kevin-horrigan/tcd-phantom/refs/REFERENCES.md

# References

PDFs are **not** committed to this repository. Most of these are under publisher copyright and
redistributing them, even for coursework, is not something a public repo should do.

**Project members:** the PDFs are in a shared Drive folder, access restricted to GWU accounts.

> https://drive.google.com/drive/folders/1BS4GFaekAu13mgtEKKH5-q6HEAU1PLzF

If that link does not open for you, ask the advisor for access rather than assuming the file is
missing. Everyone else: obtain each item through your own institutional library. Items marked **OA**
are open access and free to download from the publisher.

Annotations for each item, including what it is actually useful for, are in `../INDEX.md`.

Licence column reflects a check of the article's own front matter on 2026-09-11. Where it says
*verify*, the front page carried no clear statement and you should check the publisher page before
assuming anything.

## Phantom construction and flow loops

| # | Citation | DOI / locator | Licence |
|---|---|---|---|
| 1 | Greaby R, Zderic V, Vaezy S. Pulsatile flow phantom for ultrasound image-guided HIFU treatment of vascular injuries. *Ultrasound Med Biol* 2007;33(8):1269-1276. | 10.1016/j.ultrasmedbio.2007.02.011 | © Elsevier, all rights reserved |
| 2 | Soloukey S, Generowicz B, Warnert E, et al. Patient-specific vascular flow phantom for MRI- and Doppler ultrasound imaging. *Ultrasound Med Biol* 2024;50:860-868. | 10.1016/j.ultrasmedbio.2024.02.010 | **OA**, CC BY |
| 3 | Roldan M, Kyriacou PA. Head phantom for the acquisition of pulsatile optical signals for traumatic brain injury monitoring. *Photonics* 2023;10:504. | 10.3390/photonics10050504 *(verify)* | **OA**, CC BY |
| 4 | Qian M, Niu L, Wong KKL, Abbott D, Zhou Q, Zheng H. Pulsatile flow characterization in a vessel phantom with elastic wall using ultrasonic particle image velocimetry technique: the impact of vessel stiffness on flow dynamics. *IEEE Trans Biomed Eng* 2014;61(9):2444-2452. | IEEE TBME 61(9) | © IEEE |
| 5 | Rominger MB, Müller-Stuler E-M, Pinto M, et al. Easy pulsatile phantom for teaching and validation of flow measurements in ultrasound. Thieme, Technical Development E93. | 10.1055/s-0042-106396 | © Thieme, redistribution prohibited |
| 6 | Vanrossomme AE, Chodzyński KJ, Eker OF, Zouaoui Boudjeltia K. Development of experimental ground truth and quantification of intracranial aneurysm pulsation in a patient. *Sci Rep* 2021. | 10.1038/s41598-021-88420-3 | **OA**, CC BY *(verify)* |
| 7 | Boonya-ananta T, Rodriguez AJ, Ajmal A, et al. Development of a dynamic pulsatile phantom for the photoplethysmographic waveform at the radial artery. *J Biomed Opt*. | JBO 030-117001 | **OA**, Creative Commons |
| 8 | Gorina AV, Galiastov AA, Stavtsev DD, et al. Design of brain vessel phantom model with aneurysm for bench tests using optical flow visualization methods. *2025 STDH*, IEEE. | 10.1109/STDH66836.2025.11227509 | © IEEE |
| 9 | Brumfiel TA, Konda R, Elliott D, Desai JP. Evaluating the navigation capabilities of a modified COAST guidewire robot in an anatomical phantom model. | arXiv:2512.13477v1 | arXiv, *verify* |

## What waveform to aim at

| # | Citation | DOI / locator | Licence |
|---|---|---|---|
| 10 | Robba C, Citerio G (eds). *Echography and Doppler of the Brain.* Cham: Springer; 2021. **Ch 7, Fedriga & Czosnyka**, flow velocity, PI, autoregulation and critical closing pressure. | ISBN 978-3-030-48202-2 | © Springer. Book, not redistributable |
| 11 | Tegeler CH, Crutchfield K, Katsnelson M, et al. Transcranial Doppler velocities in a large, healthy population. *J Neuroimaging* 2013;23(3):466-472. | 10.1111/j.1552-6569.2012.00711.x *(verify)* | *verify* |
| 12 | Aaslid R, Markwalder TM, Nornes H. Noninvasive transcranial Doppler ultrasound recording of flow velocity in basal cerebral arteries. *J Neurosurg* 1982;57:769-774. | J Neurosurg 57:769 | © JNS |

## Why the waveform has that shape

| # | Citation | DOI / locator | Licence |
|---|---|---|---|
| 13 | Westerhof N, Lankhaar JW, Westerhof BE. The arterial Windkessel. *Med Biol Eng Comput* 2009;47:131-141. **Read this one first**: the accessible review of why compliance shapes an arterial waveform. | 10.1007/s11517-008-0359-2 *(verify)* | *verify* |
| 13b | Stergiopulos N, Westerhof BE, Westerhof N. Total arterial inertance as the fourth element of the windkessel model. *Am J Physiol Heart Circ Physiol* 1999;276(1):H81-H88. Earlier, shares two authors with 13, and is the copy in the Drive folder. Adds inertance as a fourth element and gives healthy human values in Table 2. Read after 13, when you need numbers. | 10.1152/ajpheart.1999.276.1.H81 | © APS |
| 14 | Shoemaker LN, Matern T, Kamar F, et al. Blood pressure in human large cerebral arteries: a feasibility study. *Am J Physiol Heart Circ Physiol* 2025. | *(verify)* | Creative Commons |
| 15 | Permutt S, Riley RL. Hemodynamics of collapsible vessels with tone: the vascular waterfall. *J Appl Physiol* 1963;18:924-932. | 10.1152/jappl.1963.18.5.924 | © APS |

## Measurement caveats that govern every velocity comparison

| # | Citation | DOI / locator | Licence |
|---|---|---|---|
| 16 | Ambrogio S, Ansell J, Gabriel E, et al. (incl. Ramnarine KV). Pulsed wave Doppler measurements of maximum velocity: dependence on sample volume size. *Ultrasound Med Biol* 2022. | Elsevier | © Elsevier, all rights reserved |
| 17 | Vilkomerson D, Ricci S, Tortoli P. Finding the peak velocity in a flow from its Doppler spectrum. *IEEE Trans Ultrason Ferroelectr Freq Control* 2013. | IEEE TUFFC | © IEEE |
| 18 | Leotta DF, Anderson M, Straccia A, et al. Measurement of transcranial Doppler insonation angles from three-dimensional reconstructions of CT angiography scans. *J Clin Monit Comput* 2024. | Springer | © Springer |

## Named in the literature but not yet obtained

These are worth chasing. The first two are the fullest build documentation that exists for the two
architectures this project is combining.

- **Greaby R (2005).** A pulsatile flow phantom for image-guided HIFU treatment of vascular injury.
  MS thesis, Bioengineering, University of Washington. Interlibrary loan.
- **Bottan S.** *In-Vitro Model of Intracranial Pressure and Cerebrospinal Fluid Dynamics.* PhD
  thesis, ETH Zurich. The ICP-pulsation reference Roldan validates against. ETH theses are usually
  openly available.
- **IEC 61685.** Ultrasonics, flow measurement systems, flow test object. The standard. Check
  institutional access before assuming you can read it.
- **Ramnarine KV, Nassiri DK, Hoskins PR, Lubbers J (1998).** Validation of a new blood-mimicking
  fluid for use in Doppler flow test objects. *Ultrasound Med Biol* 24:451-459.
- A current TCD normal-values reference for MCA velocity and PI by age. Deliberately left open:
  choosing one and justifying the choice is part of the literature review.

## Citation discipline

Verify every citation against the actual article before it goes into written work, and never cite a
paper you have not opened. Several entries above were transcribed from other papers' reference lists
rather than from the articles themselves, and the *(verify)* marks are there for a reason.
