kevin-horrigan/tcd-phantom/cad/phantom-block-drawing.png

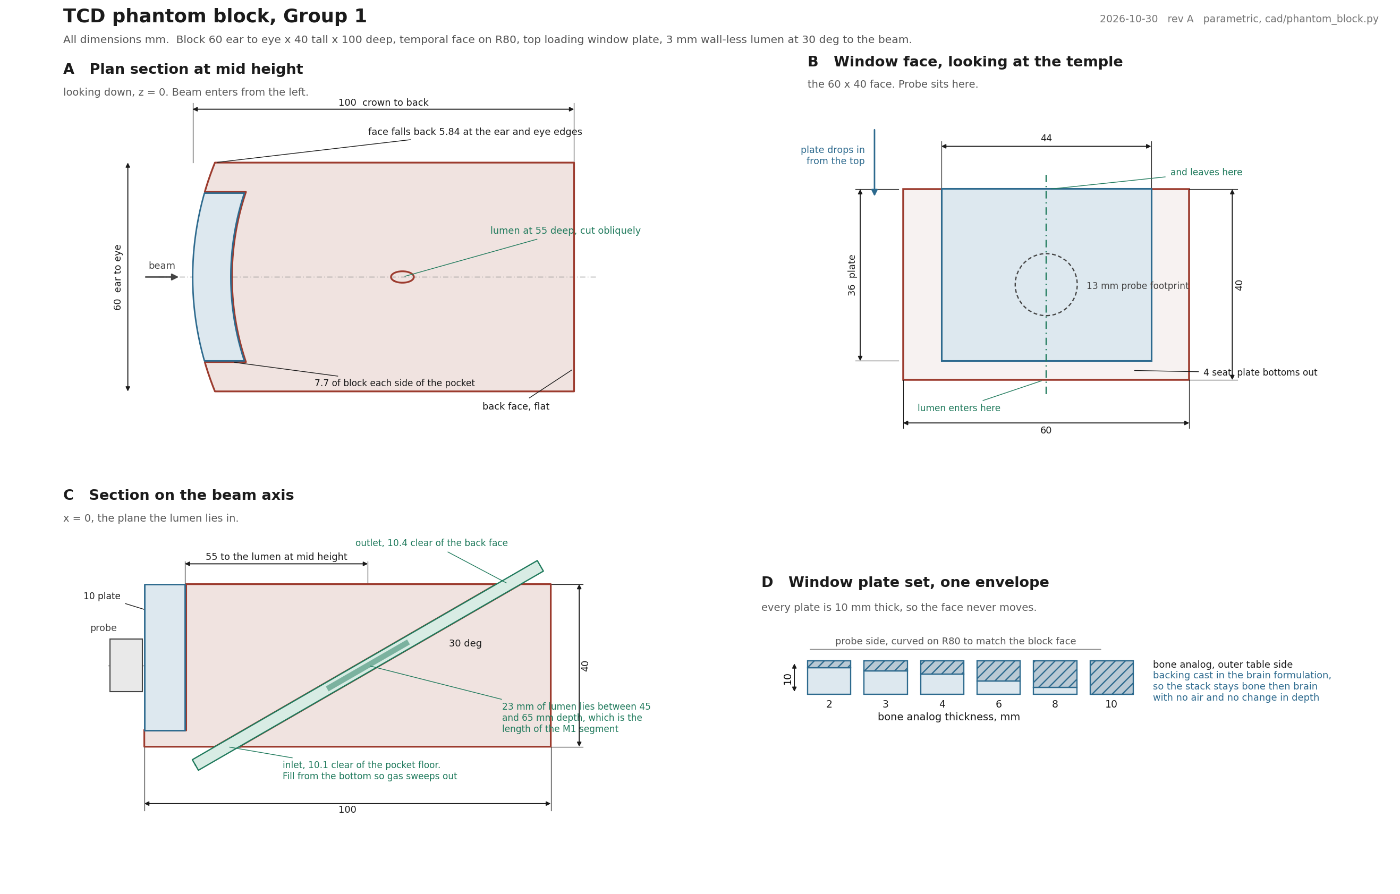
cad/phantom-block-drawing.png
