kevin-horrigan/tcd-phantom/cad/phantom-block-iso.png

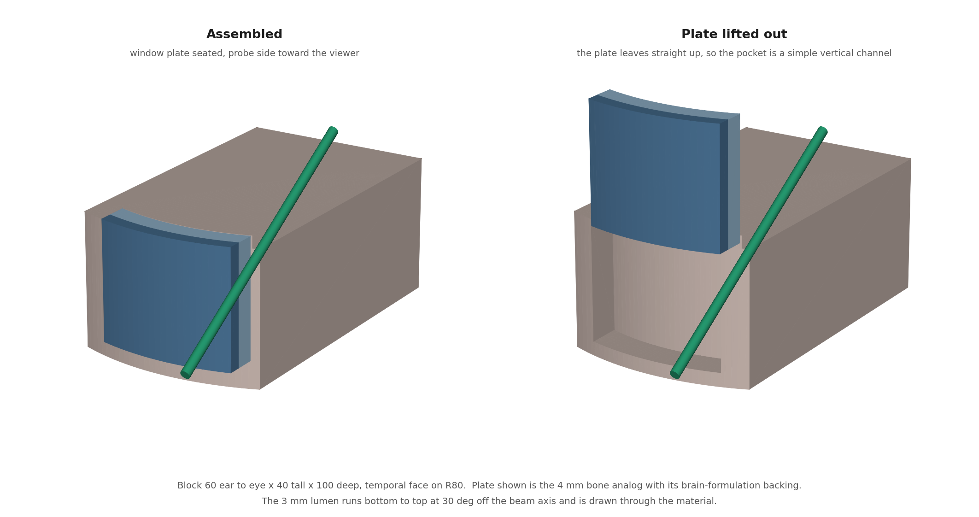
cad/phantom-block-iso.png
