kevin-horrigan/tcd-phantom/flow/architecture-fork.png

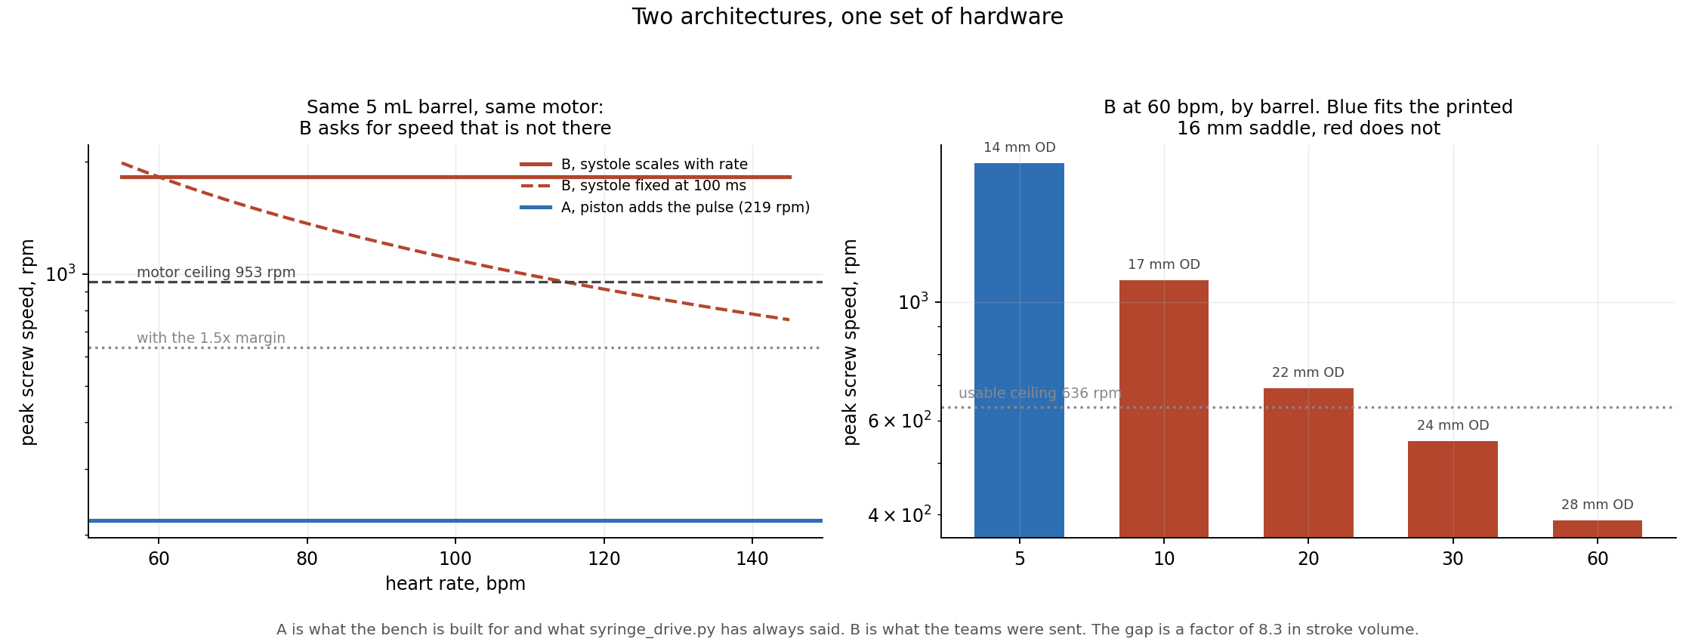
flow/architecture-fork.png
