kevin-horrigan/tcd-phantom/flow/ball-check.png

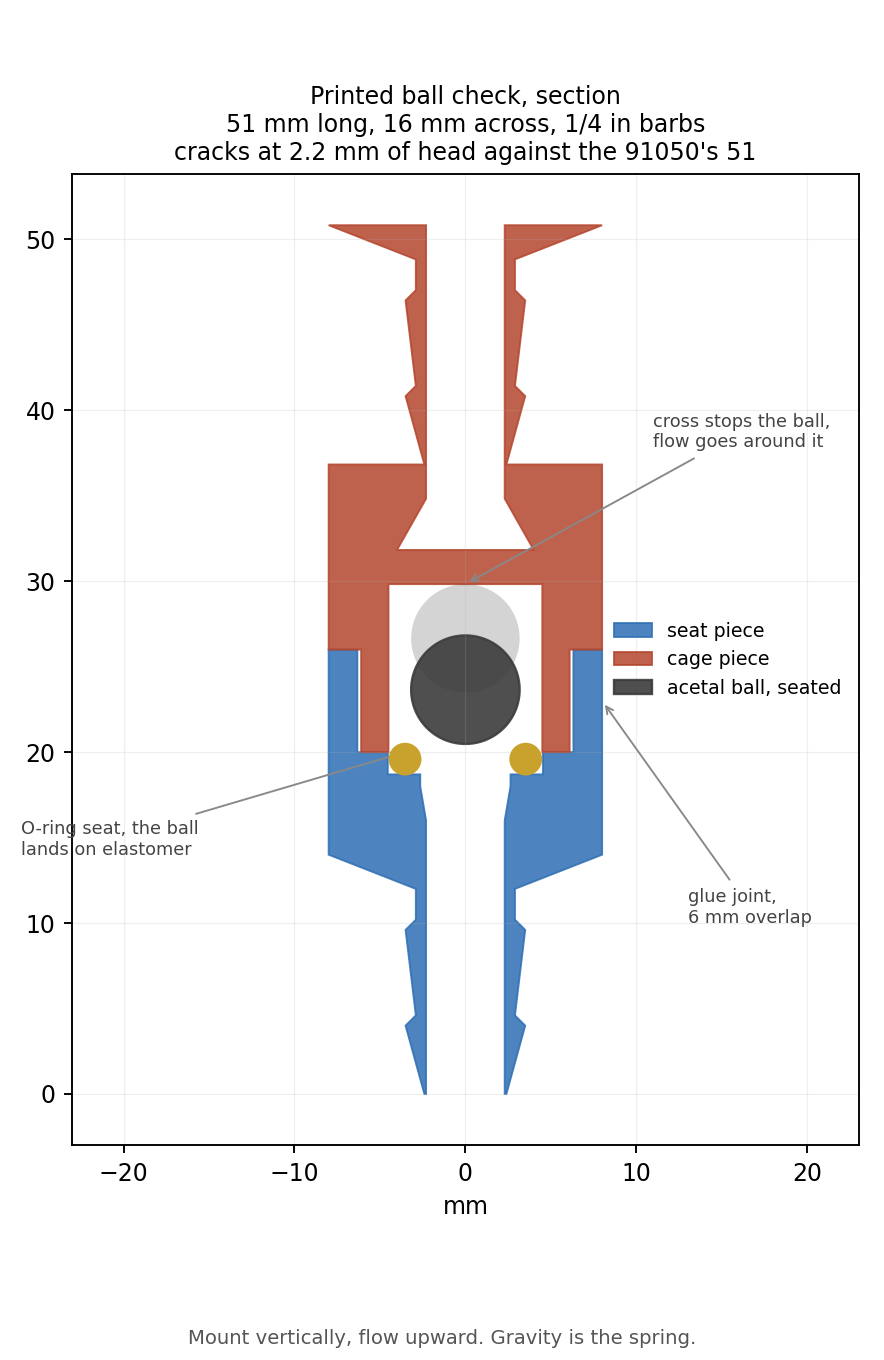
flow/ball-check.png
