kevin-horrigan/tcd-phantom/flow/bench-layout.png

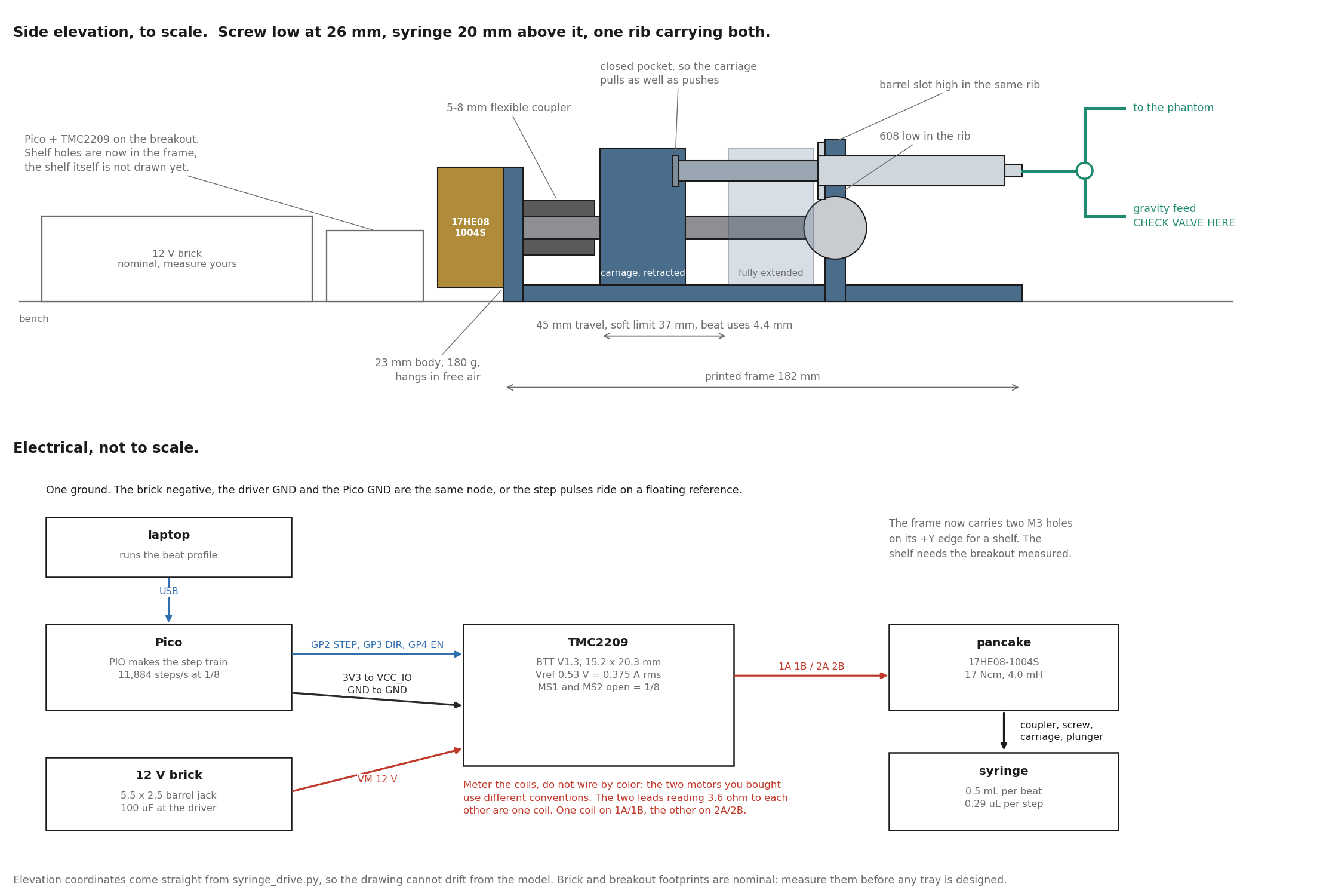
flow/bench-layout.png
