kevin-horrigan/tcd-phantom/flow/feed-tubing.png

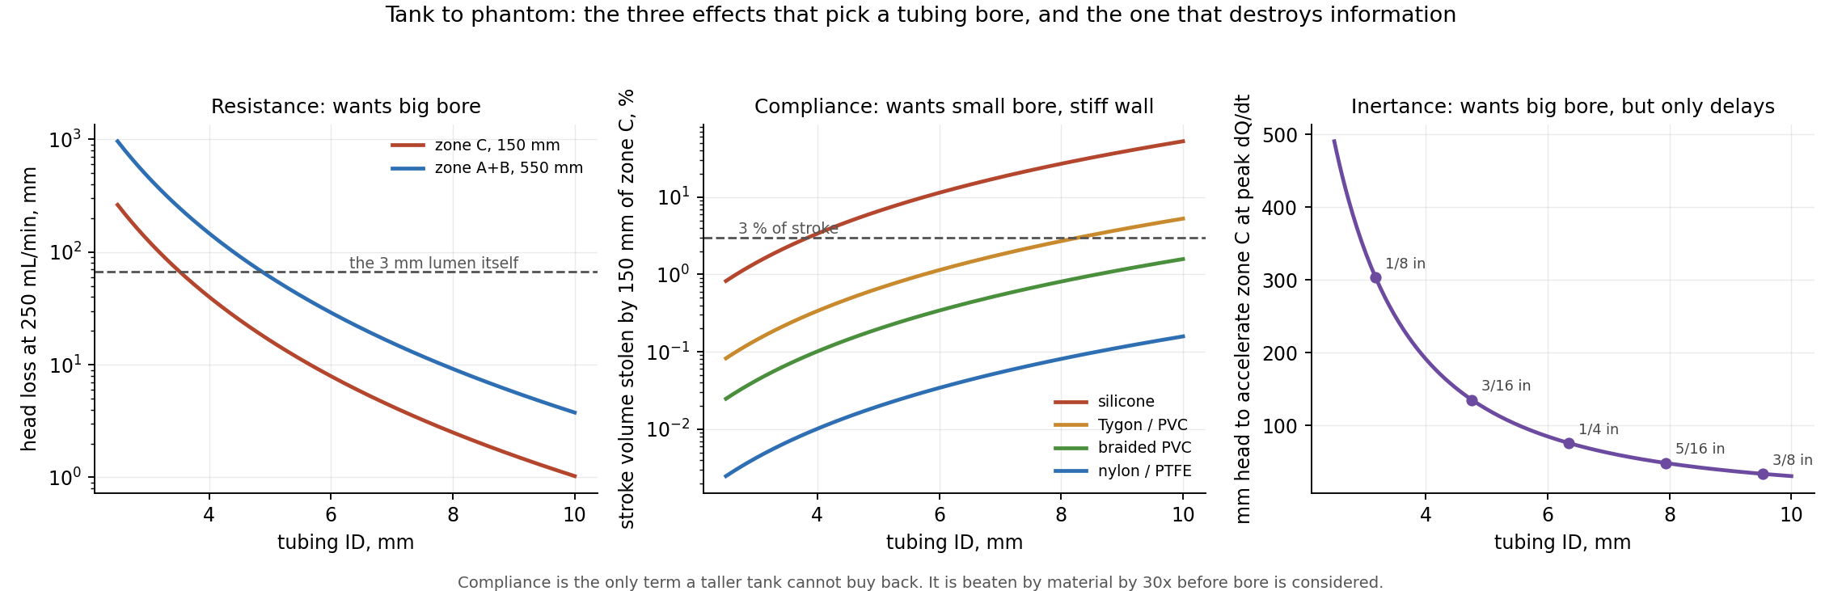
flow/feed-tubing.png
