kevin-horrigan/tcd-phantom/flow/frame-shape.png

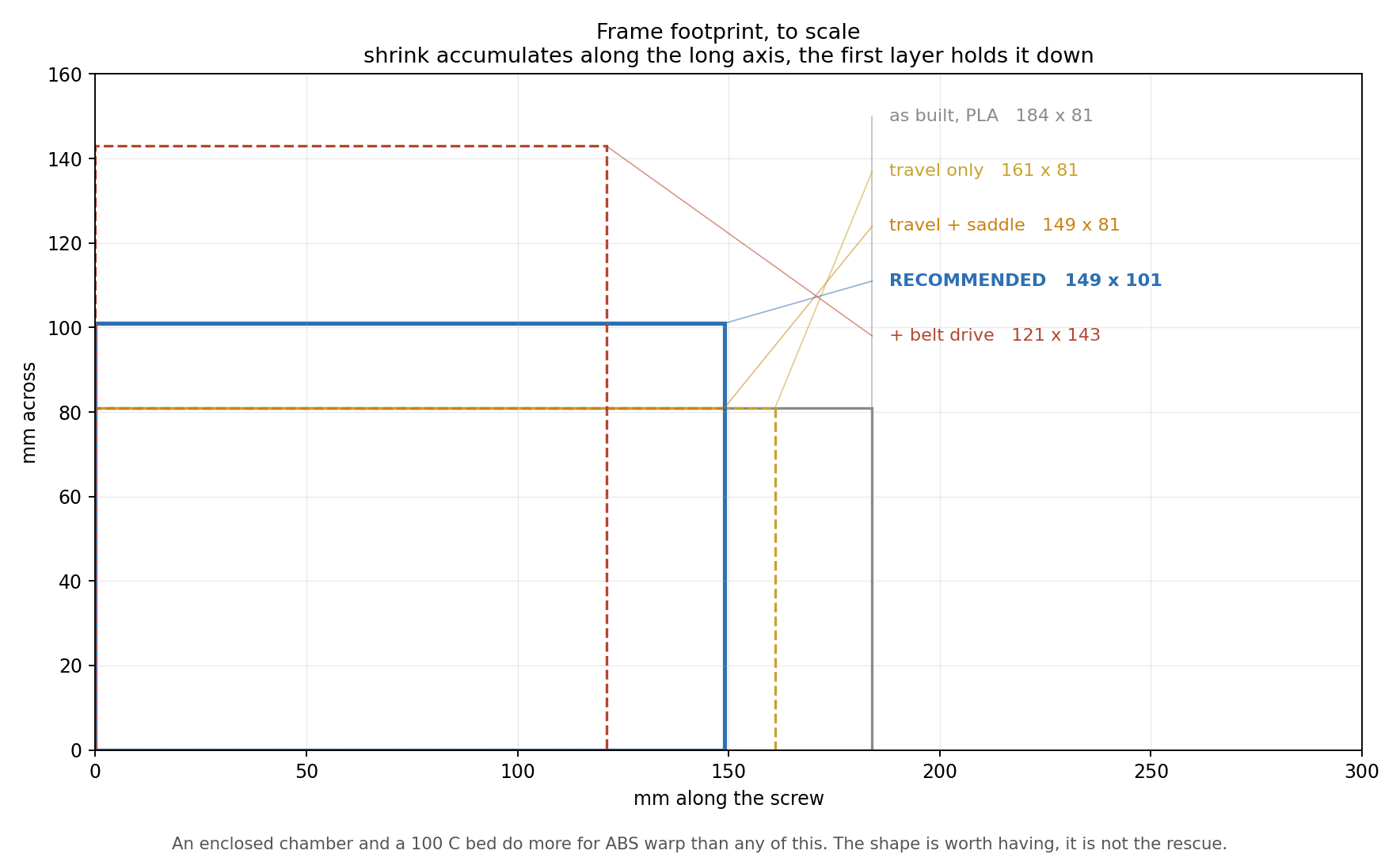
flow/frame-shape.png
