kevin-horrigan/tcd-phantom/flow/head-explained.png

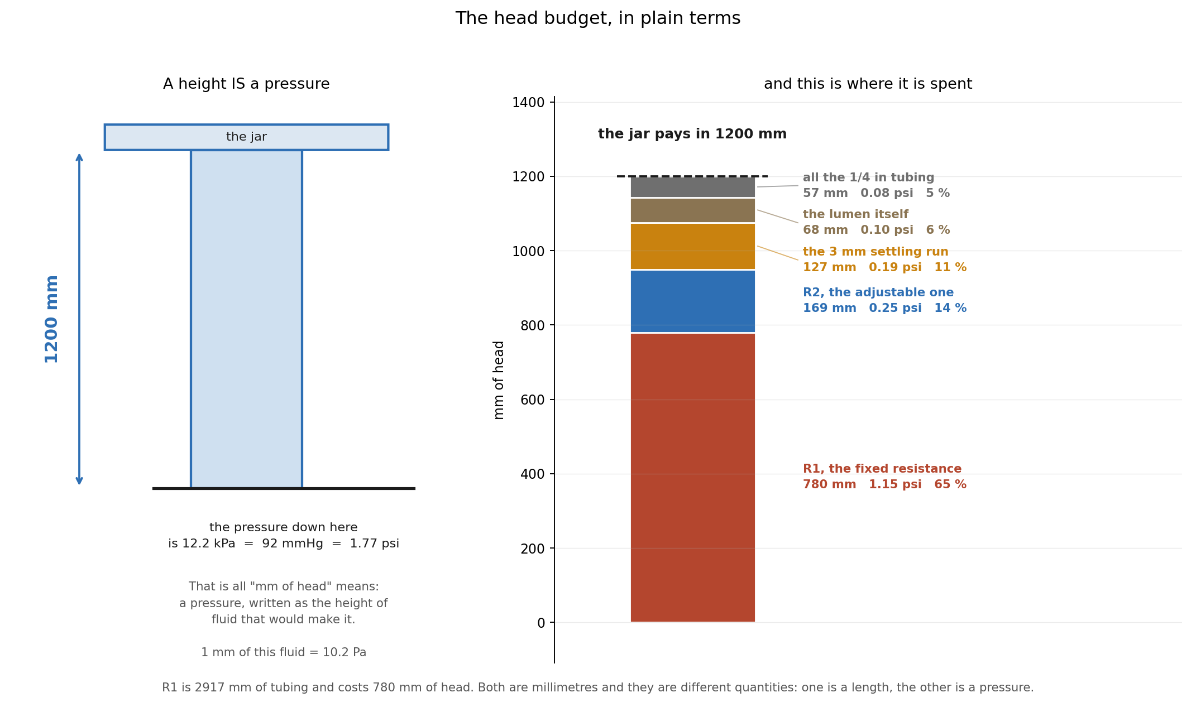
flow/head-explained.png
