kevin-horrigan/tcd-phantom/flow/instrumentation.png

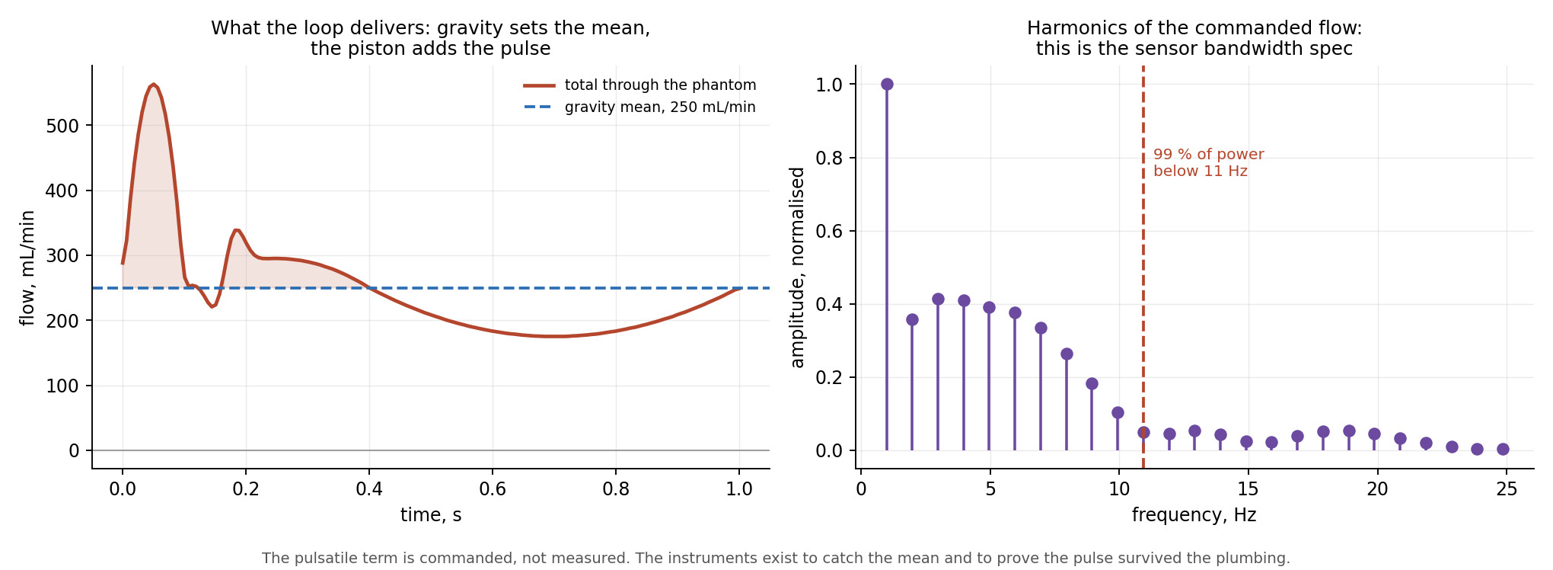
flow/instrumentation.png
