kevin-horrigan/tcd-phantom/flow/loop-diagram.png

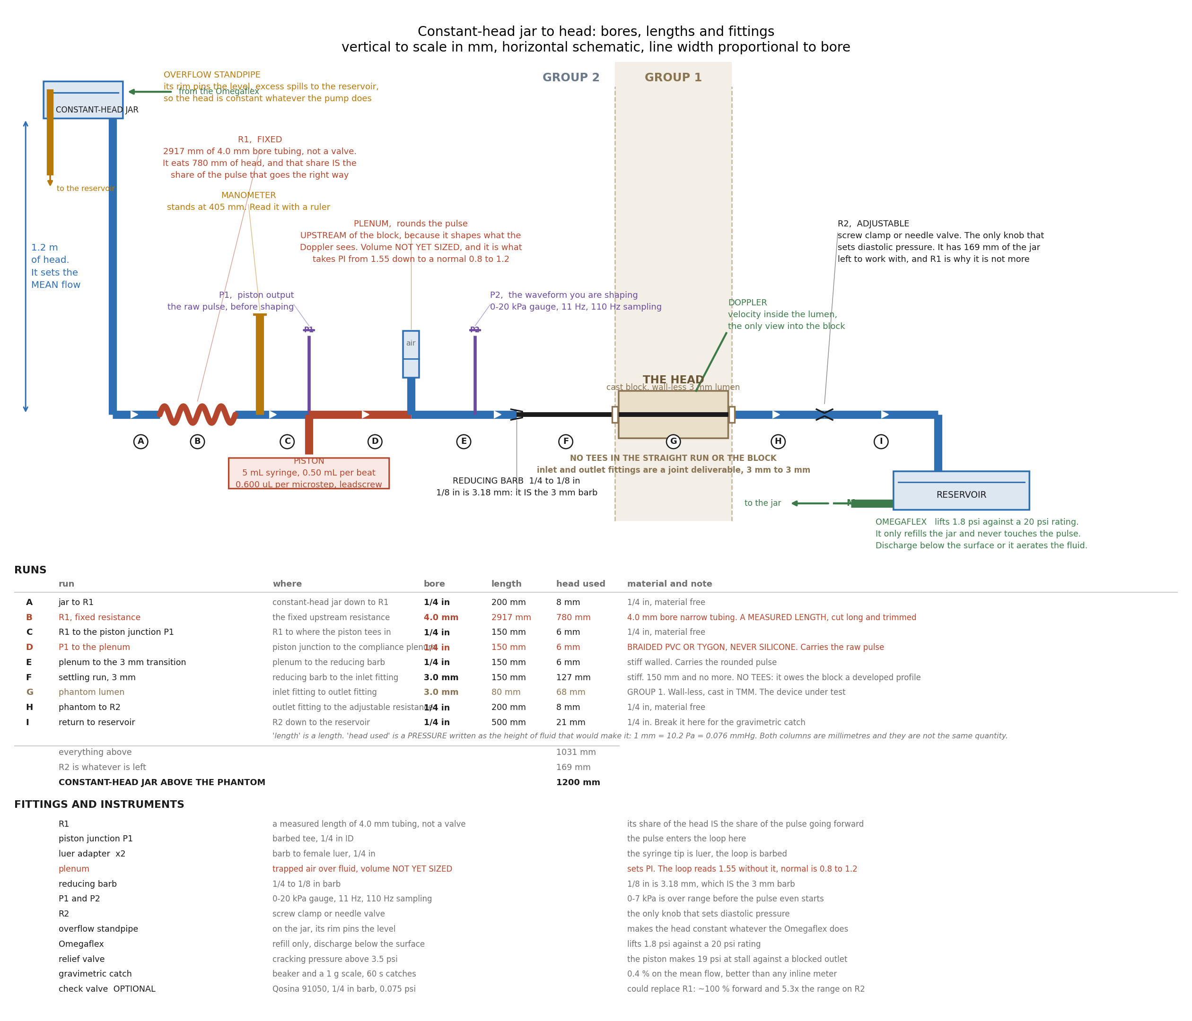
flow/loop-diagram.png
