kevin-horrigan/tcd-phantom/flow/loop-one-pager.png

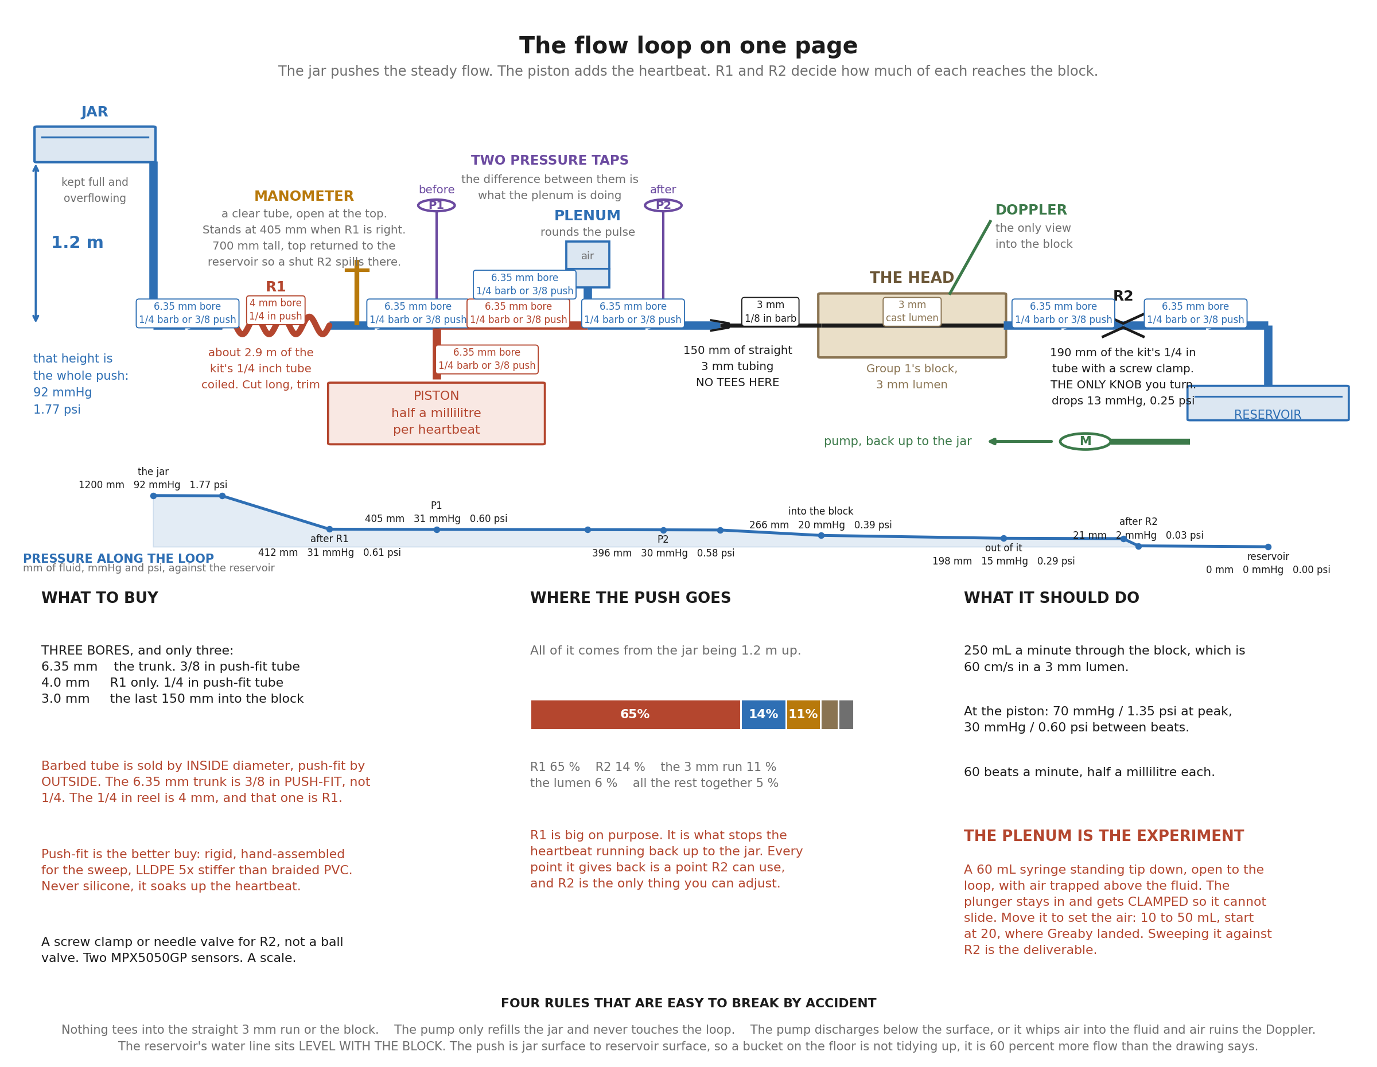
flow/loop-one-pager.png
