kevin-horrigan/tcd-phantom/flow/plenum.png

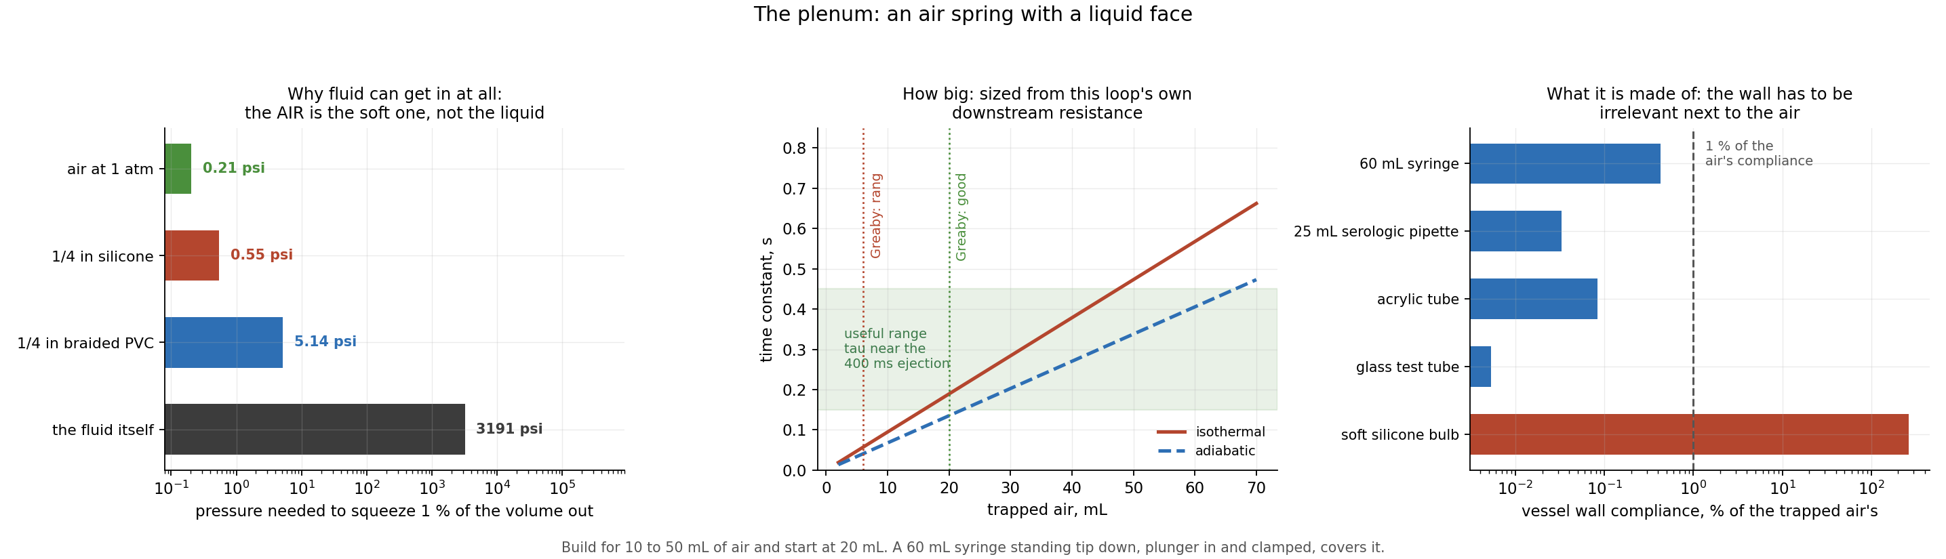
flow/plenum.png
