kevin-horrigan/tcd-phantom/flow/pressures.png

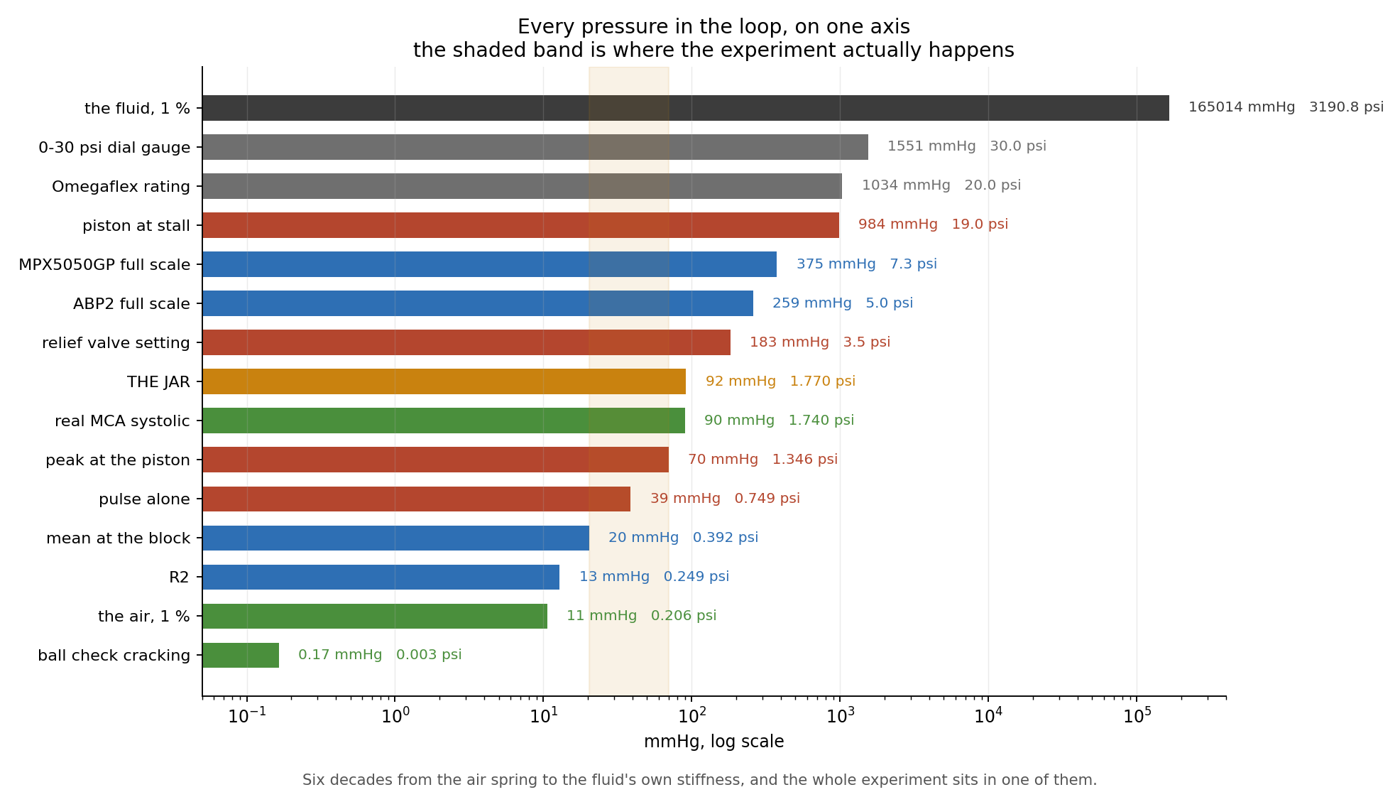
flow/pressures.png
