kevin-horrigan/tcd-phantom/flow/rod-retention.png

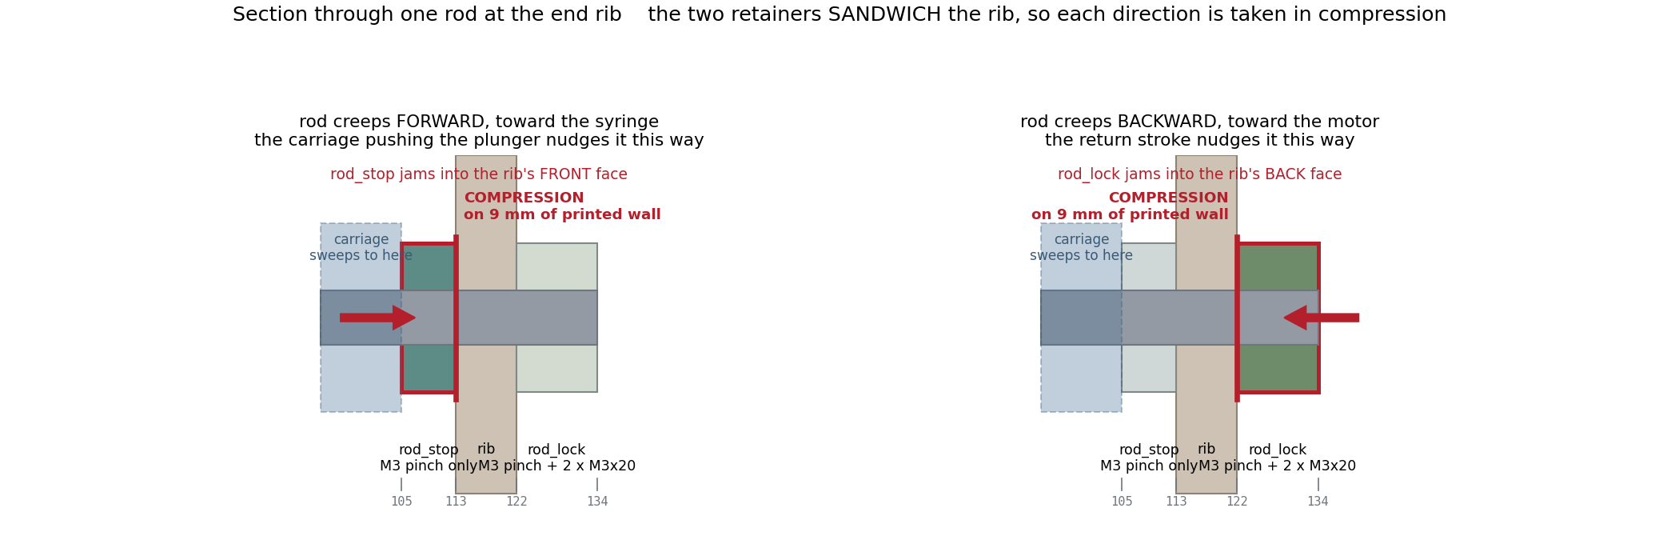
flow/rod-retention.png
