kevin-horrigan/tcd-phantom/flow/rod_lock.png

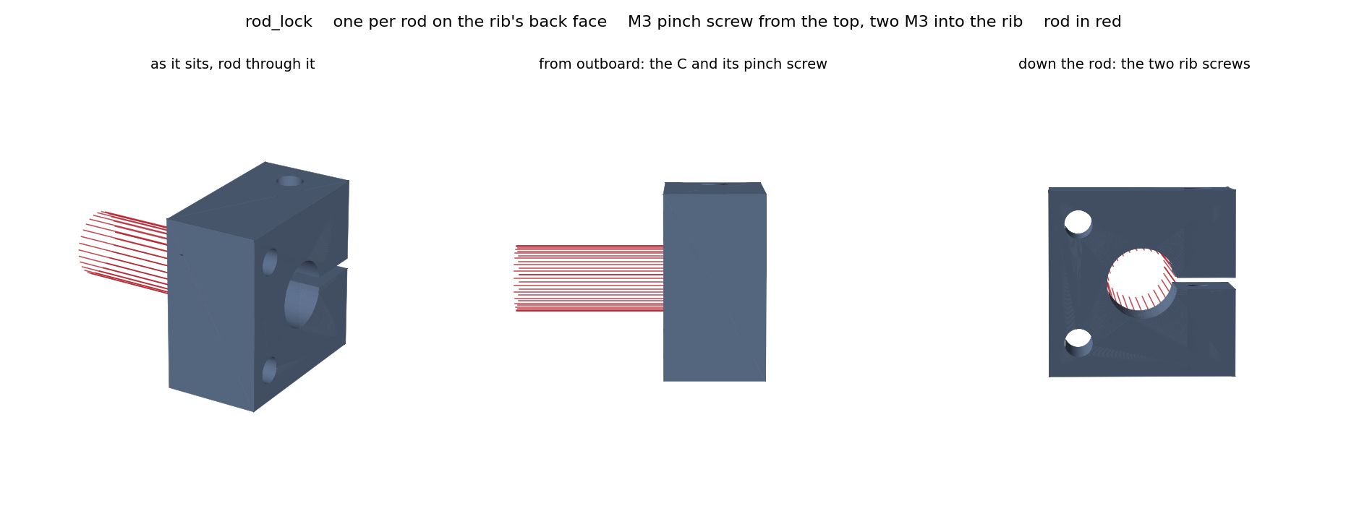
flow/rod_lock.png
