kevin-horrigan/tcd-phantom/flow/syringe-dims.png

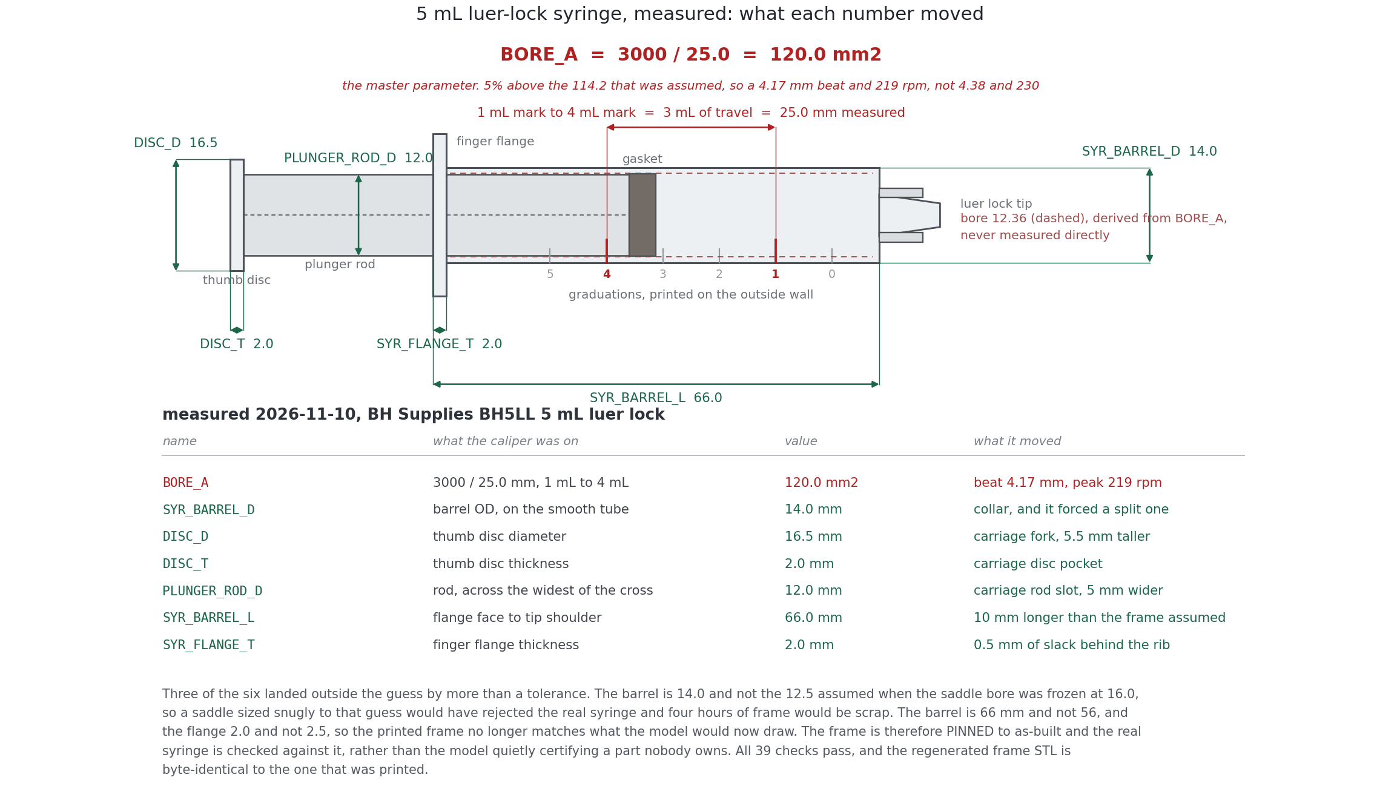
flow/syringe-dims.png
