kevin-horrigan/tcd-phantom/flow/syringe-drive.png

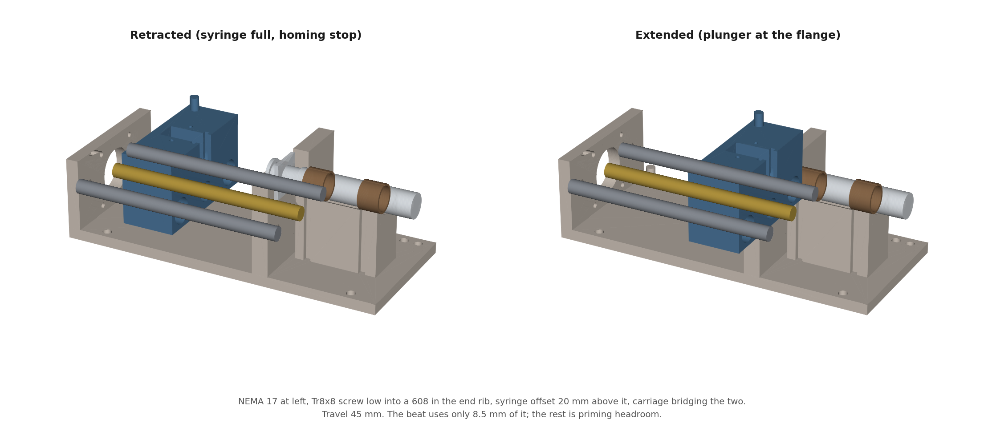
flow/syringe-drive.png
