kevin-horrigan/tcd-phantom/flow/drive-parts.png

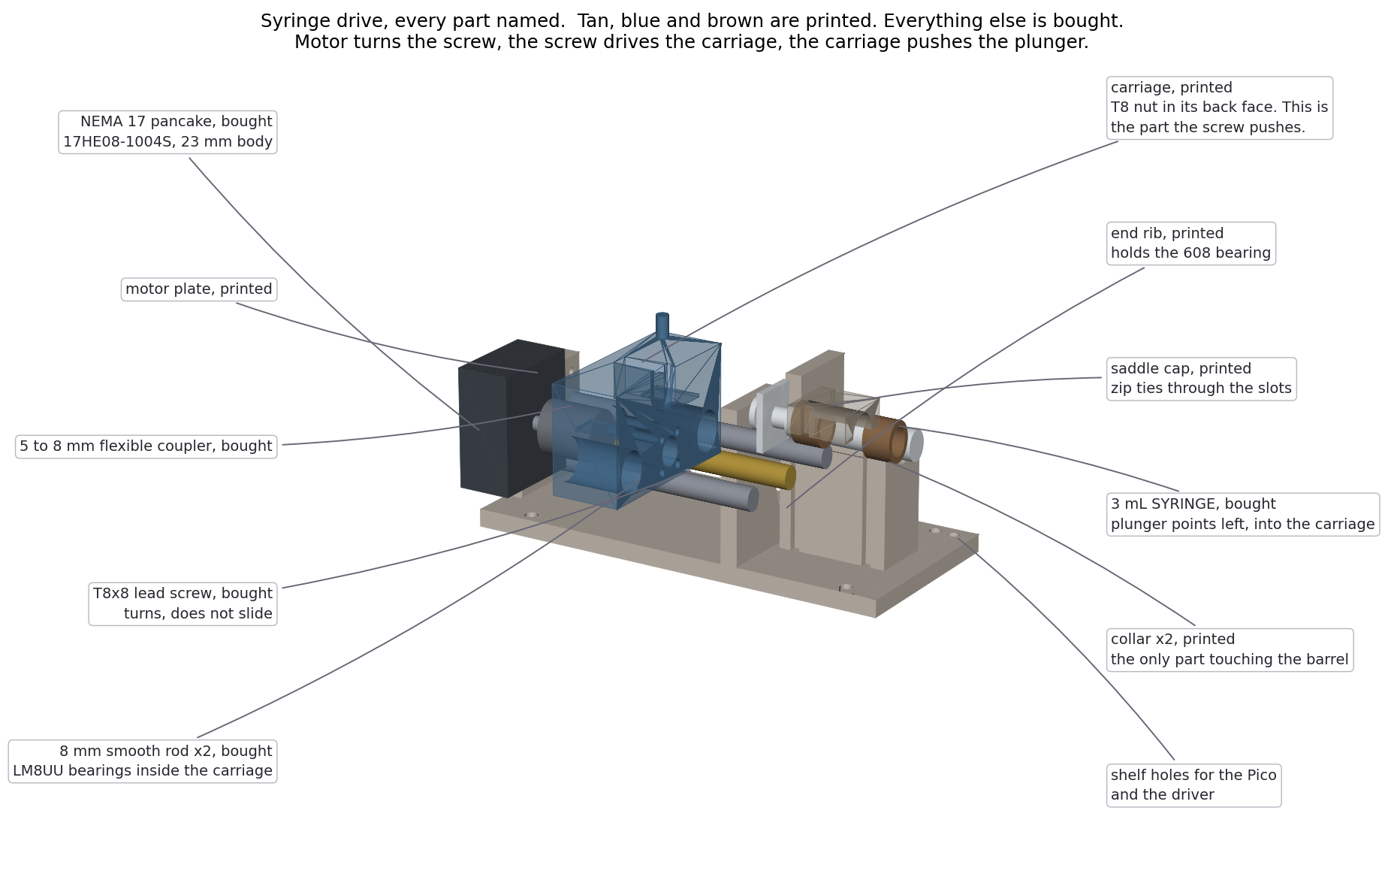
flow/drive-parts.png
