kevin-horrigan/tcd-phantom/cad/stl/plate_10mm_bone.stl

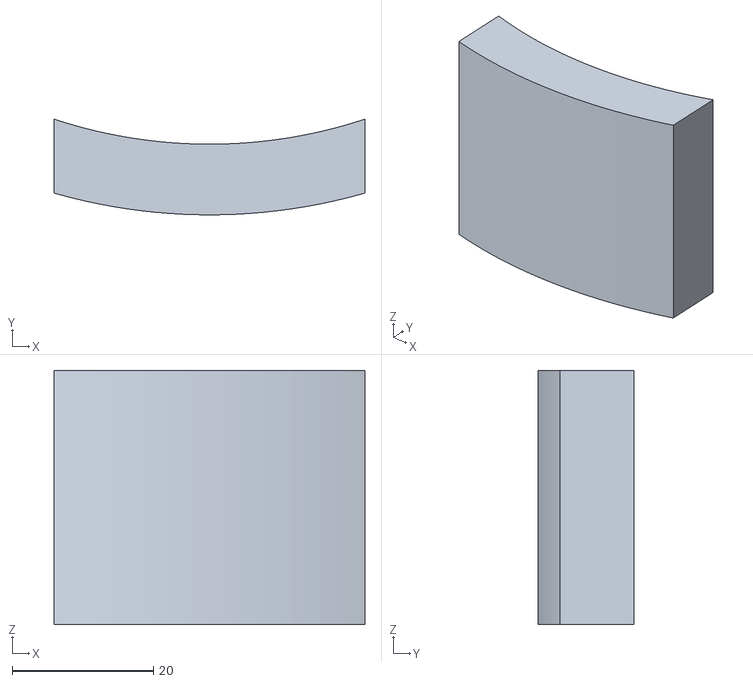
[picture p29: CAD file, 2026-11-10]
cad/stl/plate_10mm_bone.stl
44.0 x 13.5 x 36.0
