kevin-horrigan/tcd-phantom/flow/stl/plate_rods.stl

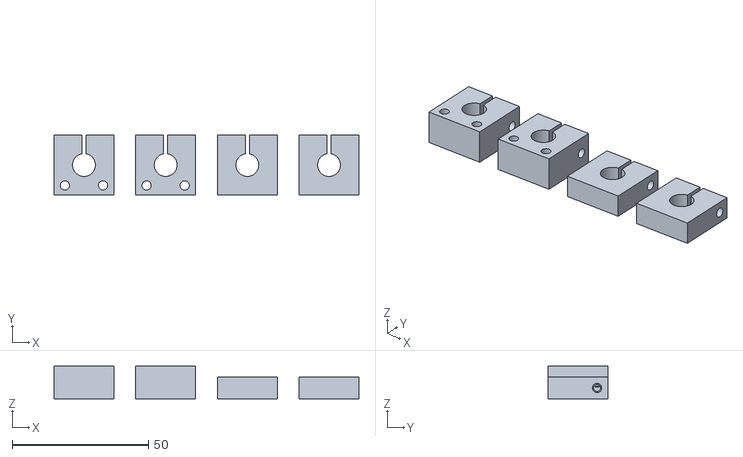
[picture p30: CAD file, 2026-11-11]
flow/stl/plate_rods.stl
112.0 x 22.0 x 12.0
