kevin-horrigan/tcd-phantom/cad/stl/plate_3mm_backing.stl

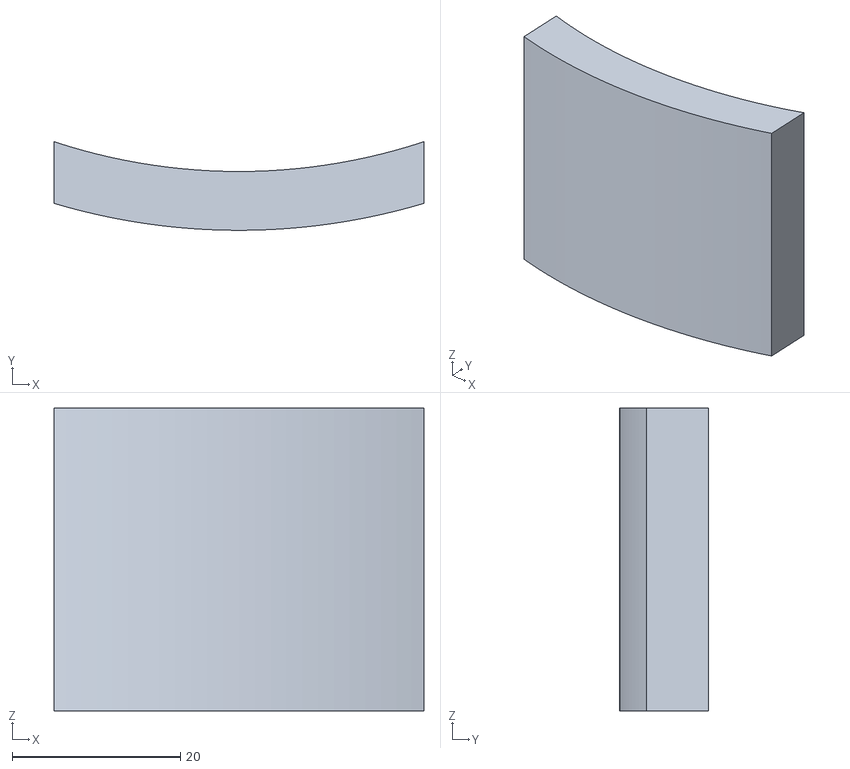
[picture p31: CAD file, 2026-11-10]
cad/stl/plate_3mm_backing.stl
44.0 x 10.5 x 36.0
