kevin-horrigan/tcd-phantom/flow/stl/rod_lock_pair.stl

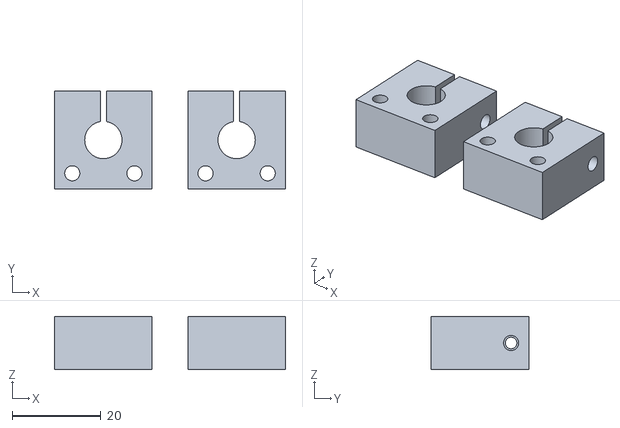
[picture p32: CAD file, 2026-11-11]
flow/stl/rod_lock_pair.stl
52.0 x 22.0 x 12.0
