kevin-horrigan/tcd-phantom/cad/stl/plate_6mm_bone.stl

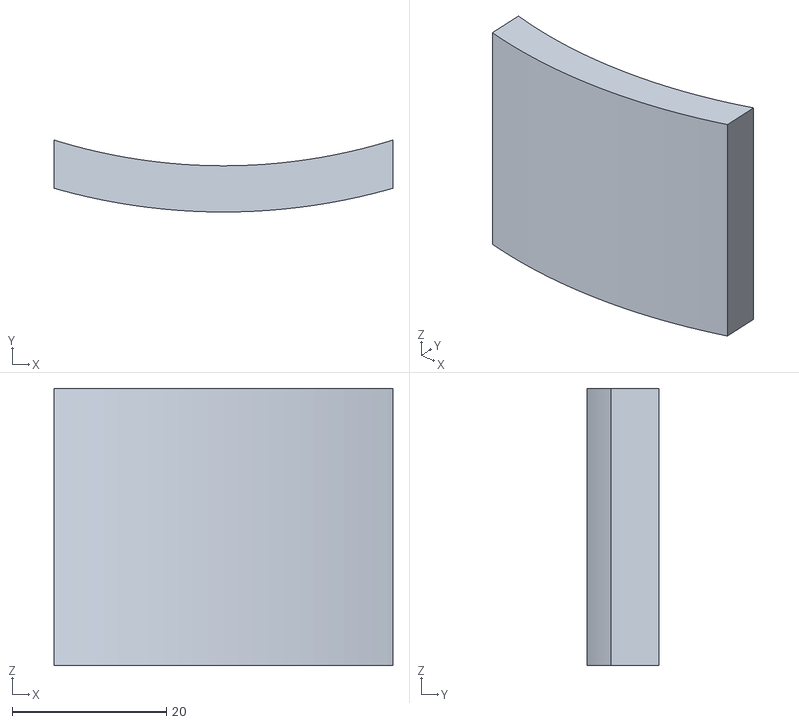
[picture p33: CAD file, 2026-11-10]
cad/stl/plate_6mm_bone.stl
44.0 x 9.35 x 36.0
