kevin-horrigan/tcd-phantom/flow/stl/carriage.stl

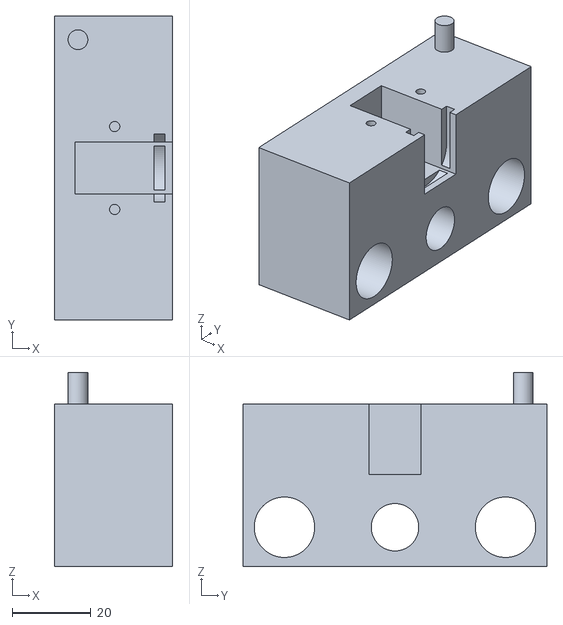
[picture p34: CAD file, 2026-11-11]
flow/stl/carriage.stl
30.0 x 77.0 x 49.2
