kevin-horrigan/tcd-phantom/cad/stl/plate_3mm_bone.stl

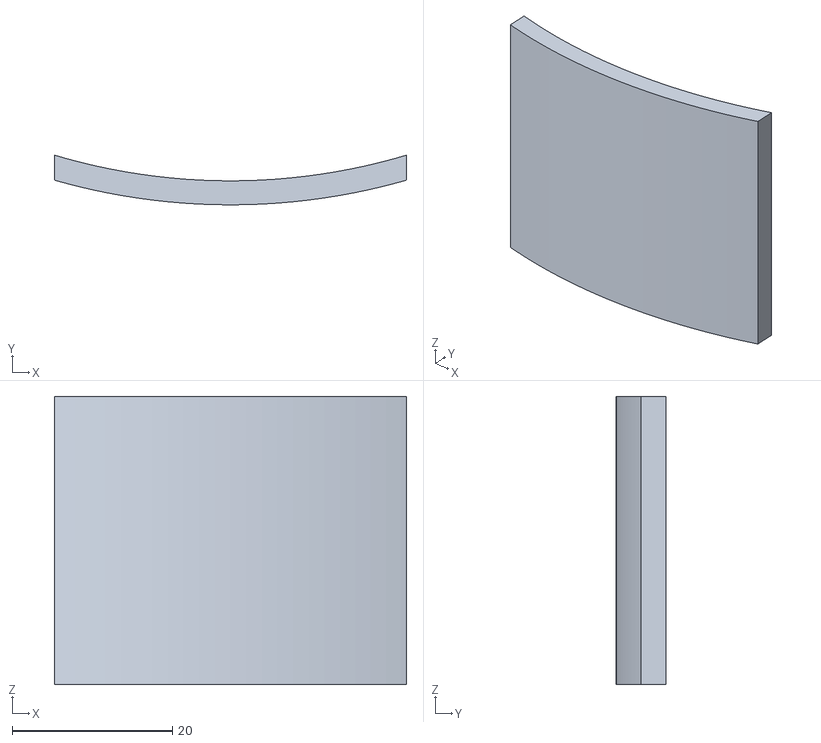
[picture p35: CAD file, 2026-11-10]
cad/stl/plate_3mm_bone.stl
44.0 x 6.21 x 36.0
