kevin-horrigan/tcd-phantom/flow/stl/plate_small.stl

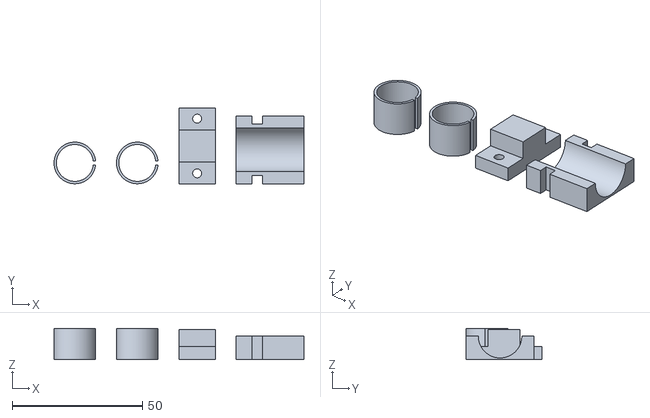
[picture p36: CAD file, 2026-11-11]
flow/stl/plate_small.stl
95.9 x 29.0 x 12.0
