kevin-horrigan/tcd-phantom/cad/stl/lumen_mandrel.stl

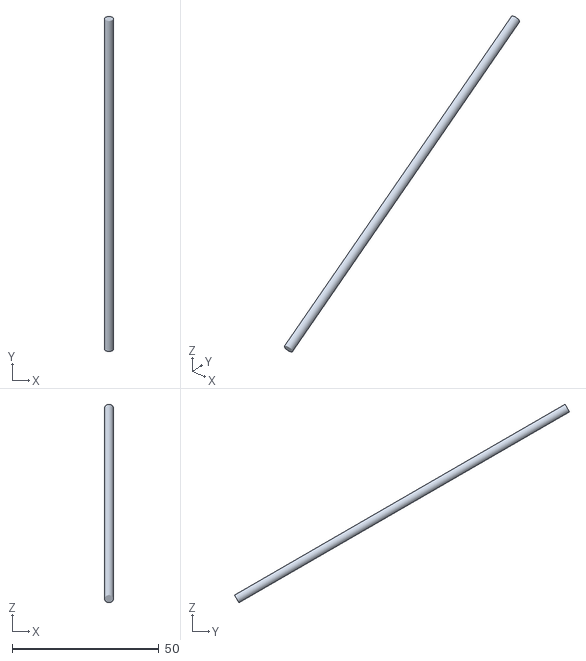
[picture p37: CAD file, 2026-11-10]
cad/stl/lumen_mandrel.stl
3.00 x 114.1 x 67.6
