kevin-horrigan/tcd-phantom/flow/stl/check_seat.stl

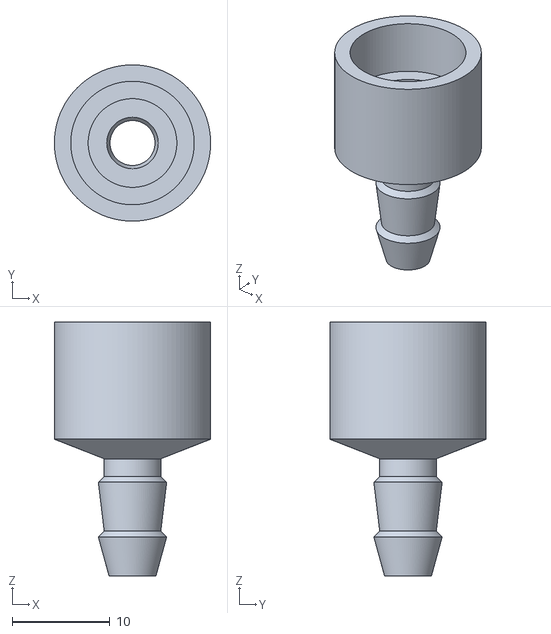
[picture p38: CAD file, 2026-11-10]
flow/stl/check_seat.stl
16.0 x 16.0 x 26.0
