kevin-horrigan/tcd-phantom/cad/stl/block.stl

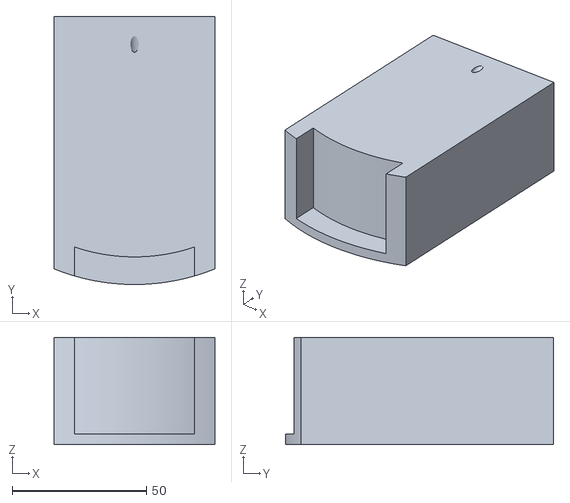
[picture p39: CAD file, 2026-11-10]
cad/stl/block.stl
60.0 x 100.0 x 40.0
