kevin-horrigan/tcd-phantom/flow/stl/check_cage.stl

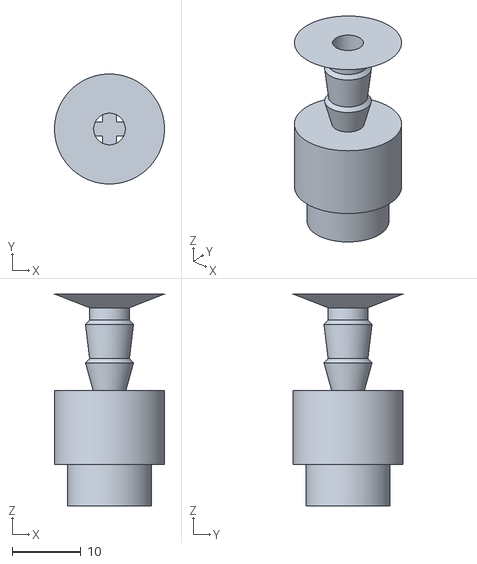
[picture p40: CAD file, 2026-11-10]
flow/stl/check_cage.stl
16.0 x 16.0 x 30.8
