kevin-horrigan/tcd-phantom/cad/stl/plate_4mm_backing.stl

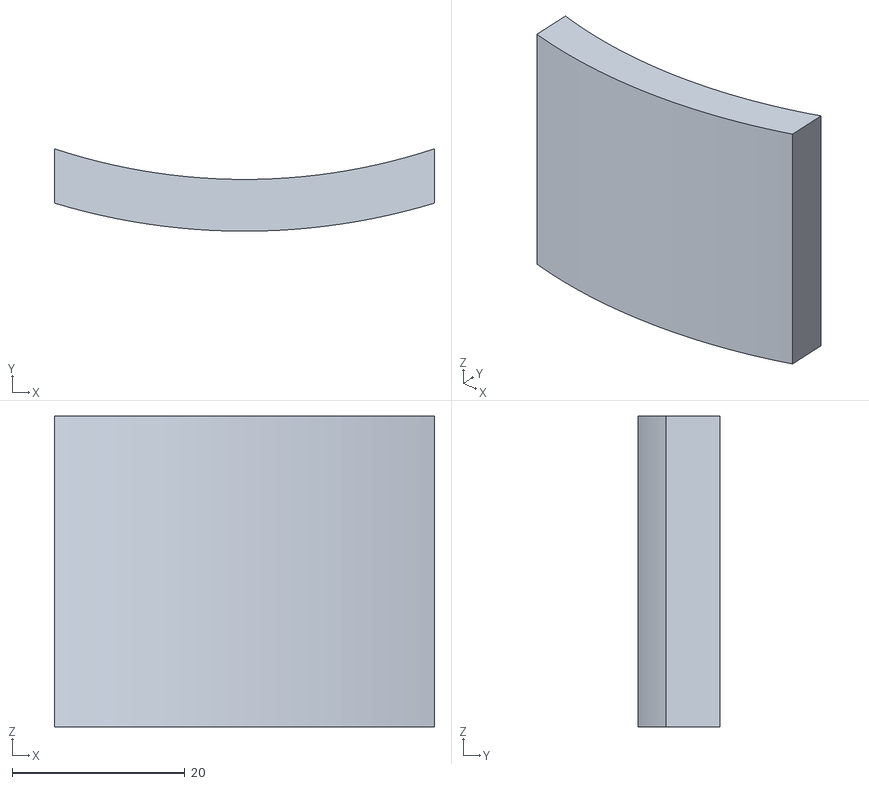
[picture p41: CAD file, 2026-11-10]
cad/stl/plate_4mm_backing.stl
44.0 x 9.55 x 36.0
