kevin-horrigan/tcd-phantom/flow/stl/rod_clamp.stl

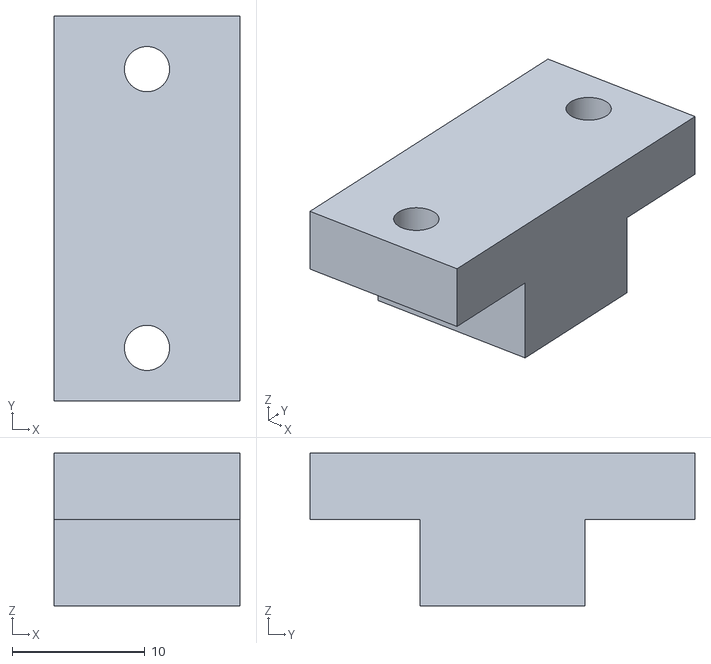
[picture p42: CAD file, 2026-11-10]
flow/stl/rod_clamp.stl
14.0 x 29.0 x 11.5
