kevin-horrigan/tcd-phantom/cad/stl/plate_8mm_bone.stl

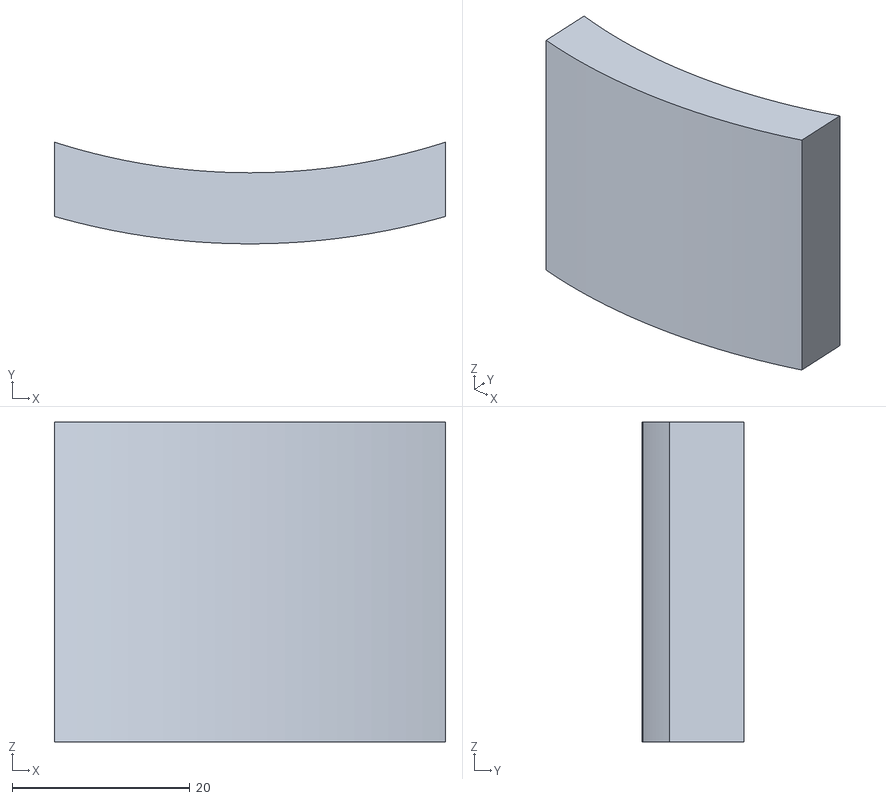
[picture p43: CAD file, 2026-11-10]
cad/stl/plate_8mm_bone.stl
44.0 x 11.4 x 36.0
