kevin-horrigan/tcd-phantom/flow/stl/collar.stl

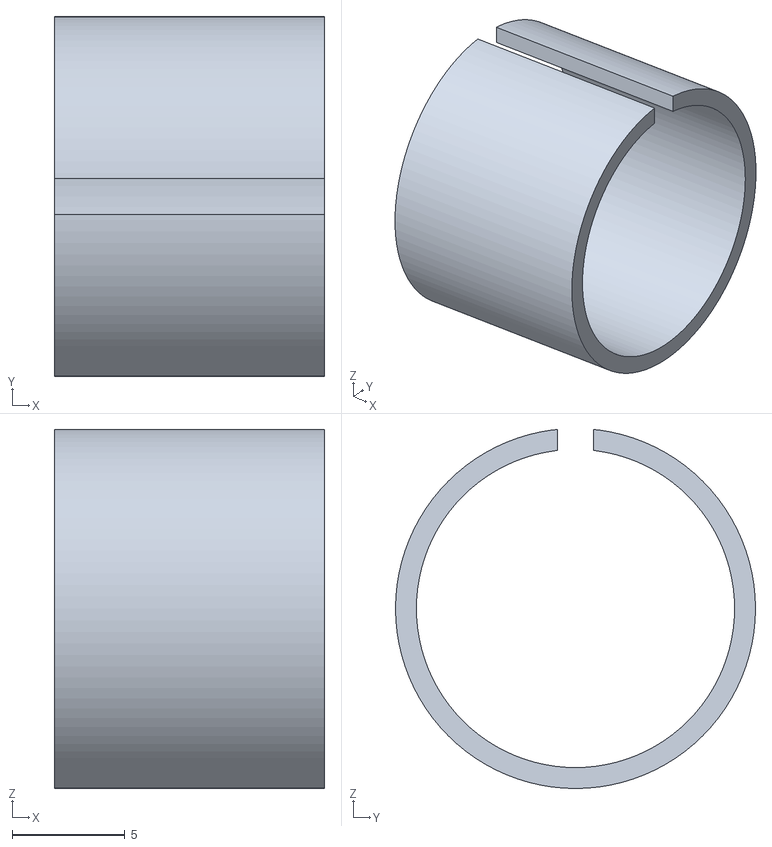
[picture p44: CAD file, 2026-11-10]
flow/stl/collar.stl
12.0 x 16.0 x 16.0
