kevin-horrigan/tcd-phantom/cad/stl/plate_2mm_bone.stl

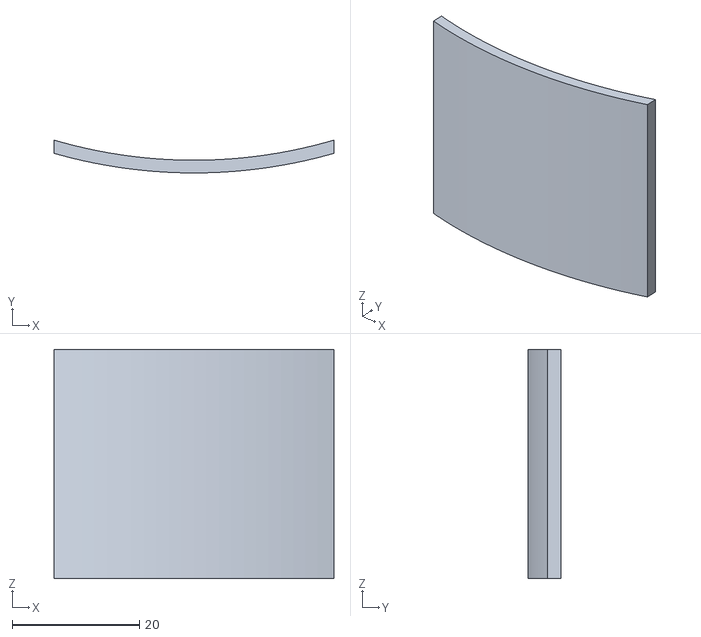
[picture p45: CAD file, 2026-11-10]
cad/stl/plate_2mm_bone.stl
44.0 x 5.17 x 36.0
