kevin-horrigan/tcd-phantom/flow/stl/saddle_cap.stl

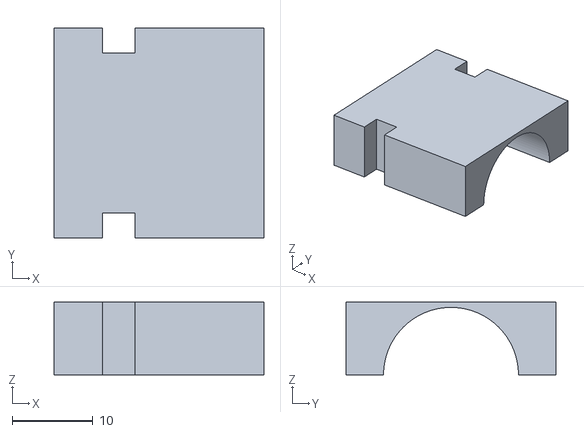
[picture p46: CAD file, 2026-11-10]
flow/stl/saddle_cap.stl
26.0 x 26.0 x 9.00
