kevin-horrigan/tcd-phantom/cad/stl/plate_4mm_bone.stl

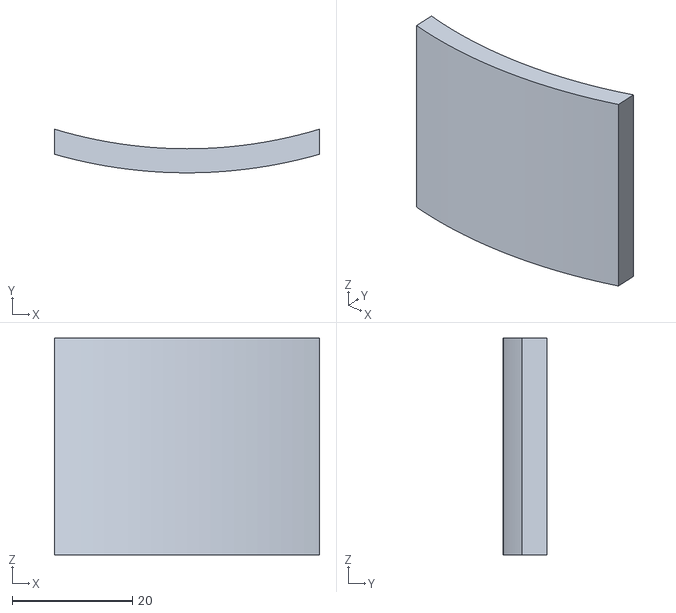
[picture p47: CAD file, 2026-11-10]
cad/stl/plate_4mm_bone.stl
44.0 x 7.25 x 36.0
