kevin-horrigan/tcd-phantom/flow/stl/frame.stl

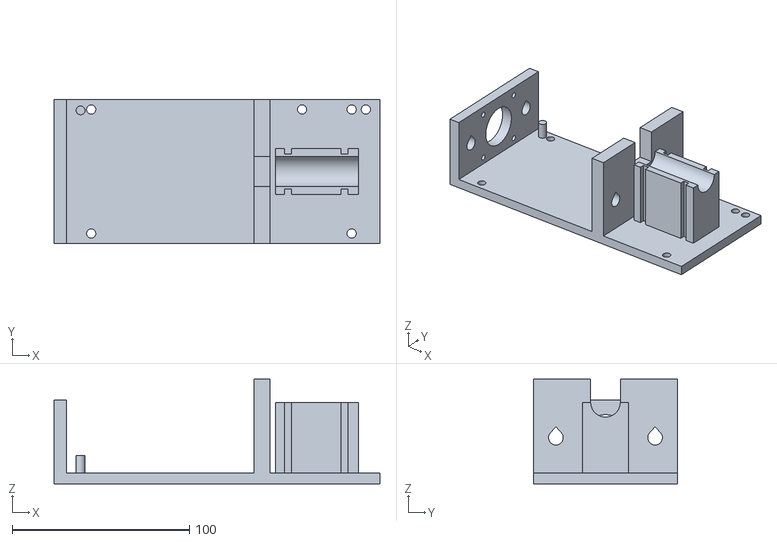
[picture p48: CAD file, 2026-11-10]
flow/stl/frame.stl
184.0 x 81.0 x 59.0
