kevin-horrigan/tcd-phantom/cad/stl/plate_2mm_backing.stl

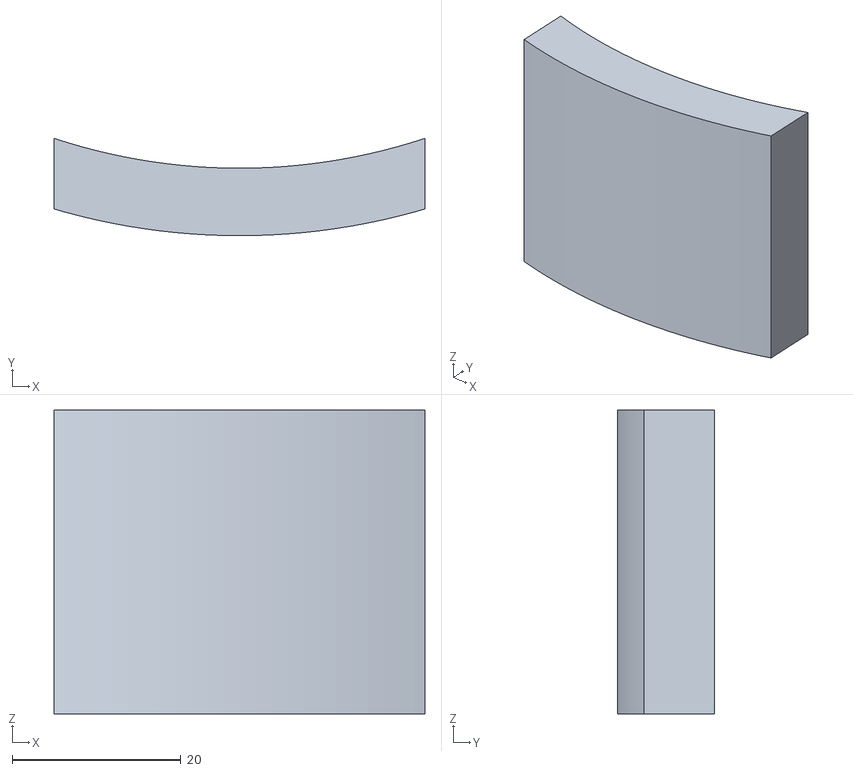
[picture p49: CAD file, 2026-11-10]
cad/stl/plate_2mm_backing.stl
44.0 x 11.5 x 36.0
