kevin-horrigan/tcd-phantom/flow/stl/fit_coupon.stl

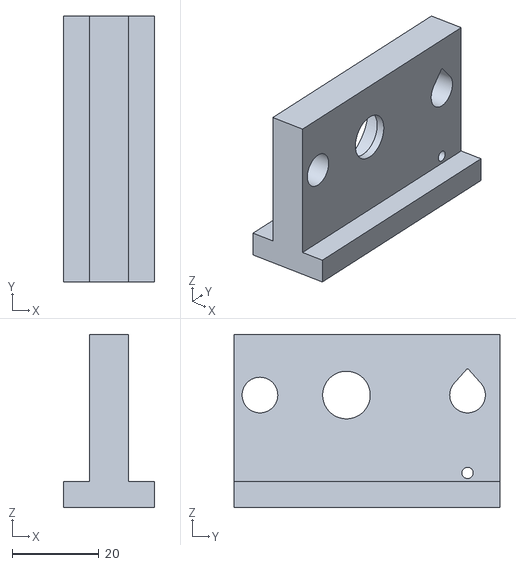
[picture p50: CAD file, 2026-11-10]
flow/stl/fit_coupon.stl
21.0 x 61.5 x 40.0
