kevin-horrigan/tcd-phantom/cad/stl/plate_6mm_backing.stl

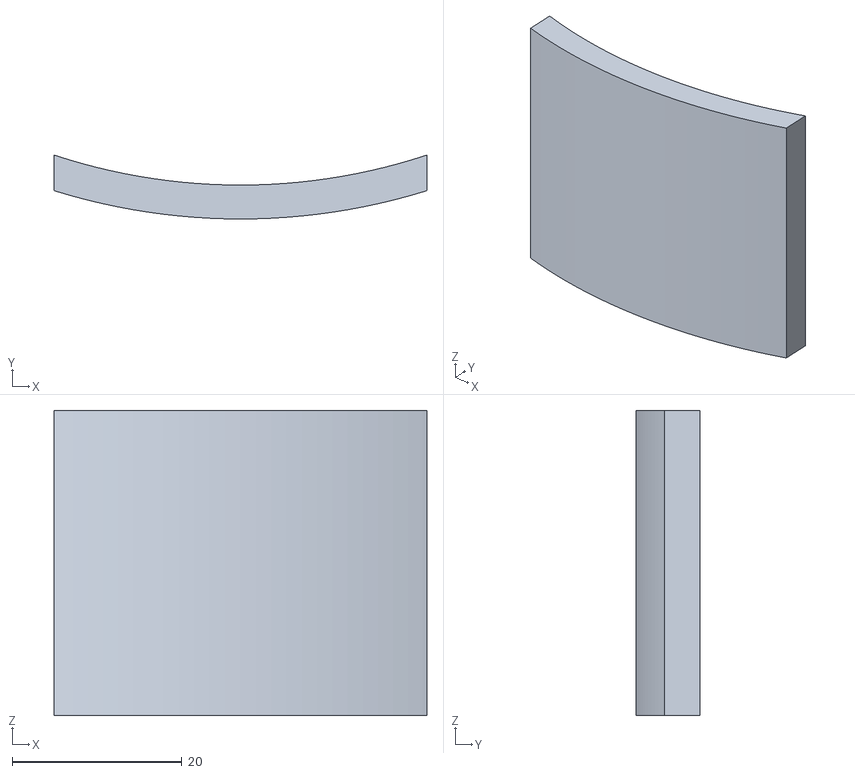
[picture p51: CAD file, 2026-11-10]
cad/stl/plate_6mm_backing.stl
44.0 x 7.55 x 36.0
