kevin-horrigan/tcd-phantom/cad/stl/plate_8mm_backing.stl

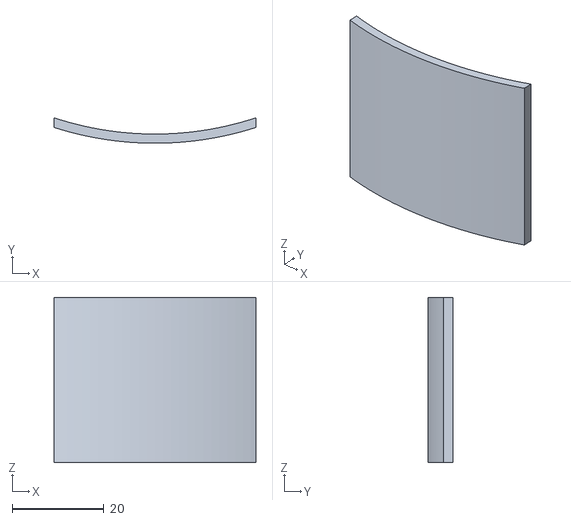
[picture p52: CAD file, 2026-11-10]
cad/stl/plate_8mm_backing.stl
44.0 x 5.55 x 36.0
