kevin-horrigan/tcd-phantom/flow/print-plate.png

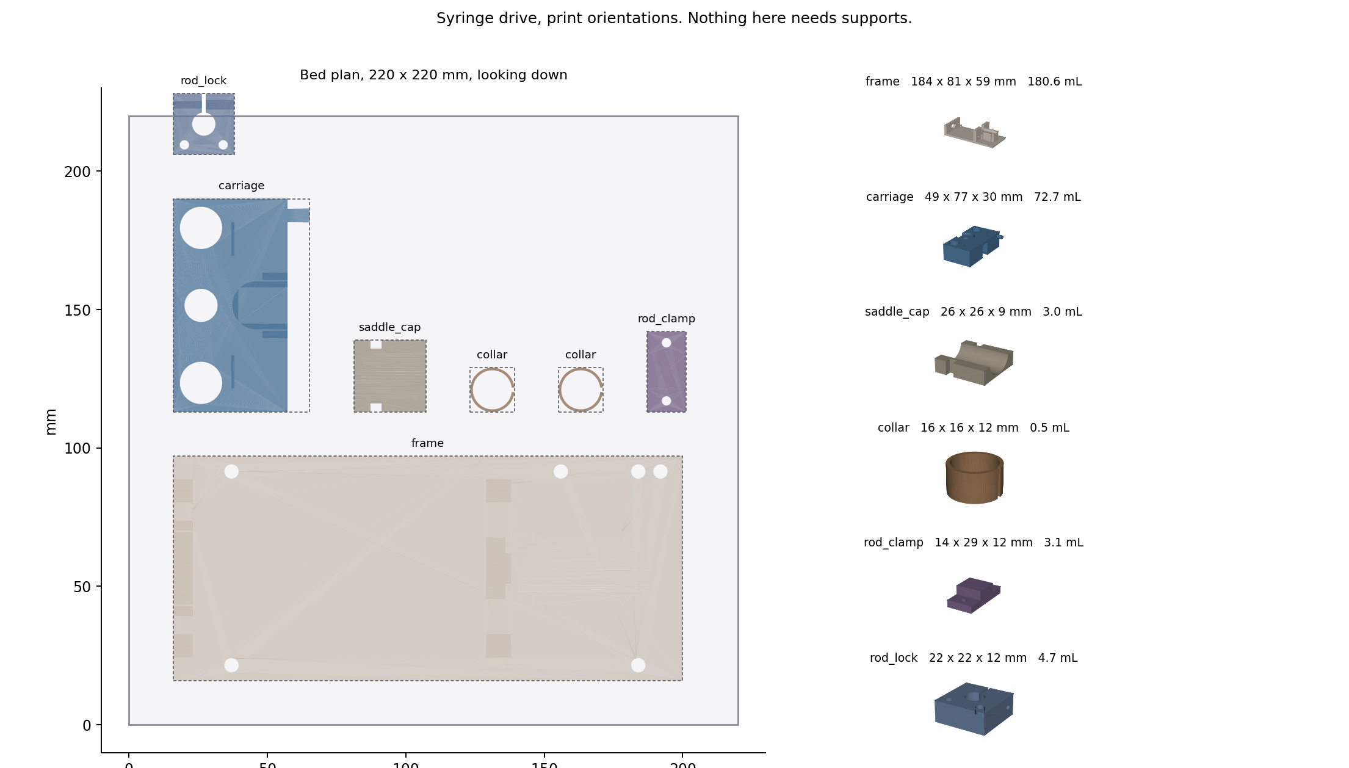
flow/print-plate.png
