kevin-horrigan/tcd-phantom/flow/wiring.png

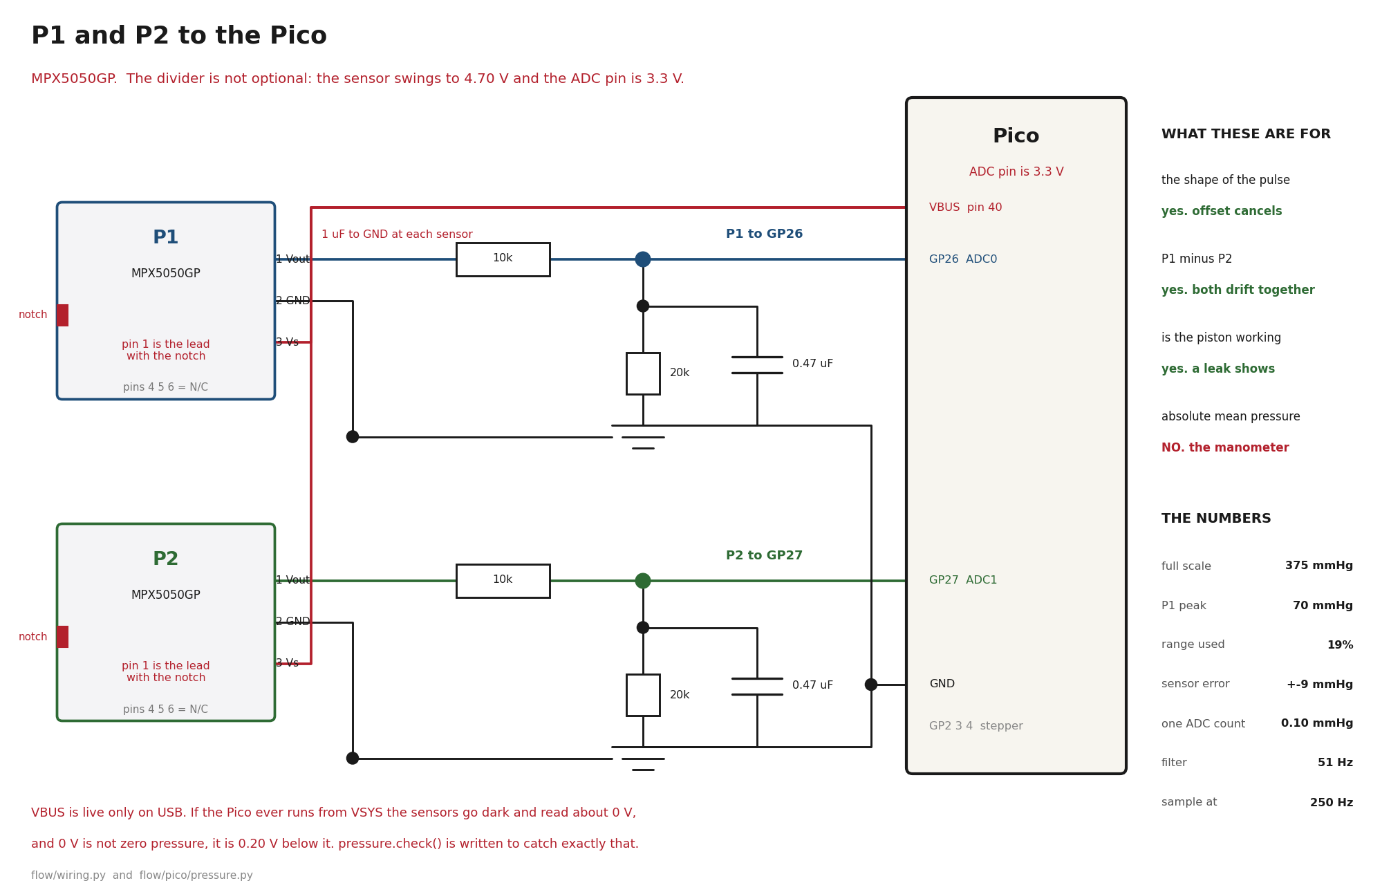
flow/wiring.png
