kevin-horrigan/tcd-phantom/flow/instrumentation.py

# -*- coding: utf-8 -*-
"""What to measure on the loop, and what the instruments have to be.

    python instrumentation.py   ->  instrumentation.png + the tables below

Two questions, and they have different answers than they look like they do.

PRESSURE. The whole signal lives in under one psi. A 622 mm column of
blood-mimicking fluid is 0.90 psi, and the pulse riding on it is smaller
still. Put that into an ordinary 0 to 30 psi dial gauge and the entire
experiment happens inside the first three percent of the dial, below the
width of the needle. Range is the specification that matters here, ahead of
accuracy class, ahead of everything. And one instrument cannot do both jobs:
setting the constriction wants a slow absolute reading, and seeing whether
systole survived the plumbing wants something that can follow a 100 ms rise.

VELOCITY. The pulsatile part does not need measuring, because it is already
known better than any sensor on this bench could report it. The piston is a
positive displacement pump commanded in exact step counts at 0.600 uL per
step. What needs measuring is the MEAN, which gravity sets and which nothing
commands, and that is a beaker and a scale. The sensor question is really
"did the pulse arrive", and that is a pressure measurement, not a flow one.

Nothing here names a part number. The 9105x episode is recent enough: these
are specifications, and the part that meets them has to be checked against
its own datasheet before anyone orders it.
"""
import math
import os

import numpy as np
import matplotlib
matplotlib.use("Agg")
import matplotlib.pyplot as plt

import syringe_drive as S
from head_budget import TANK_MM as H_TANK

HERE = os.path.dirname(os.path.abspath(__file__))
RHO, G, MU = 1037.0, 9.80665, 4.1e-3
PSI, MMHG, KPA = 6894.757, 133.322, 1000.0
Q_MEAN = 250.0                      # mL/min
TANK_MM = H_TANK                    # the constant-head jar, 1.2 m
BEAT_HZ = 1.0

# Commodity full-scale ranges, psi. The point of this list is how badly the
# usual ones fit, not which to buy.
RANGES = [
    ("dial gauge, 0-100 psi", 100.0, "the one in every lab drawer"),
    ("dial gauge, 0-30 psi", 30.0, "the one people buy for this"),
    ("dial gauge, 0-15 psi", 15.0, "still ten times too coarse"),
    ("transducer, 0-5 psi", 5.0, "getting there"),
    ("transducer, 0-20 kPa", 20.0 * KPA / PSI, "THE SPEC. Peak fits with room"),
    ("transducer, 0-10 kPa", 10.0 * KPA / PSI, "mean plus pulse just clips it"),
    ("transducer, 0-7 kPa", 7.0 * KPA / PSI, "pulse alone fills it. Too tight"),
    ("standpipe, mm of fluid", TANK_MM * RHO * G * 1e-3 / PSI, "a clear tube"),
]

SCALE_G = 1.0                       # kitchen scale resolution, grams
PHONE_FPS = 240.0
CLEAR_RUN_MM = 100.0


def head_pa(mm):
    return RHO * G * mm * 1e-3


def head_mm(pa):
    return pa / (RHO * G) * 1e3


def piston_flow():
    """Commanded flow and its derivative, from the real BEAT array."""
    try:
        import pico.config as C
        beat = np.asarray(C.BEAT, dtype=float)
    except Exception:
        import assembly as A
        beat = np.asarray(A.beat(), dtype=float)
    t = np.linspace(0.0, 1.0 / BEAT_HZ, len(beat))
    dt = t[1] - t[0]
    x = beat * S.BEAT_MM * 1e-3
    q = np.gradient(x, dt) * (S.BORE_A * 1e-6)
    return t, q, np.gradient(q, dt)


def spectrum(t, q):
    """Harmonic content of the commanded flow, as a fraction of total power.

    This is what sets the sensor bandwidth. A rise-time rule of thumb gives
    one number; the actual array gives the right one, and the array is what
    the firmware plays.
    """
    n = len(q)
    f = np.fft.rfftfreq(n, t[1] - t[0])
    a = np.abs(np.fft.rfft(q - q.mean()))
    p = a ** 2
    return f, a, np.cumsum(p) / p.sum()


def main():
    A = print
    t, q, dqdt = piston_flow()
    f, amp, cum = spectrum(t, q)
    q_mean_si = Q_MEAN * 1e-6 / 60.0
    q_peak = q.max() + q_mean_si
    stroke_m3 = S.BEAT_ML * 1e-6

    # ------------------------------------------------------------ pressure
    # Taken off head_budget's own segment list rather than halving the tank
    # height, so the two files cannot drift apart.
    import head_budget as H
    # By ZONE, not by list position. This used to slice SEGMENTS as seg[:3]
    # and seg[3:], which silently meant something different the moment the
    # topology changed, and the topology did change: the plenum moved
    # upstream of the phantom and a check valve became an R1.
    up_mm = H.seg_head("up")
    down_mm = H.seg_head("shape") + H.seg_head("lumen") + H.seg_head("down")
    crack_mm = 0.0                                # no check valve in the loop
    constrict_mm = TANK_MM - up_mm - down_mm - crack_mm
    r_down = head_pa(down_mm + constrict_mm) / (Q_MEAN * 1e-6 / 60.0)
    pp_pa = r_down * q.max()                      # peak piston flow x downstream R

    A("WHAT PRESSURE THIS LOOP ACTUALLY MAKES")
    # mm of fluid first, because that is the unit the head budget is written
    # in and the unit a standpipe reads in without being asked.
    A("  %-36s %9s %8s %8s %9s" % ("", "mm fluid", "psi", "kPa", "mmHg"))
    for nm, mm in (("tank head, static, no flow", TANK_MM),
                   ("mean at the piston tee", TANK_MM - crack_mm - up_mm),
                   ("mean at the phantom inlet",
                    constrict_mm + H.seg_head("lumen") + H.seg_head("down")),
                   ("PULSE, peak piston flow x R_down", head_mm(pp_pa)),
                   ("a 91050 check valve, IF one is added", 50.8),
                   ("the printed ball check alone", 2.2)):
        pa = head_pa(mm)
        A("  %-36s %9.0f %8.3f %8.2f %9.1f"
          % (nm, mm, pa / PSI, pa / KPA, pa / MMHG))
    A("")
    A("  The pulse line is a first-order estimate: peak commanded piston flow")
    A("  through the resistance downstream of the tee, ignoring compliance and")
    A("  the gravity leg backing off as pressure rises. A real number needs a")
    A("  network solve. What it is good for is a sanity check, and it lands at")
    A("  %.0f mmHg against the 40 mmHg that feed_tubing.py assumed when it"
      % (pp_pa / MMHG))
    A("  priced tubing compliance. Two independent routes to the same size, so")
    A("  that assumption can stay.")
    A("")
    A("  A real MCA runs near 90/60 mmHg. This loop runs at about a third of")
    A("  that, and on purpose: it reproduces VELOCITY, and the interface")
    A("  control document says a soft cast gel will not hold arterial")
    A("  pressure anyway. Nobody should be surprised when the trace has the")
    A("  right shape and a third of the amplitude.")
    A("")

    A("WHY THE USUAL GAUGE WILL NOT DO")
    A("  Signal is the %.0f mmHg pulse derived above. 'of FS' is how much of"
      % (pp_pa / MMHG))
    A("  the dial it uses, and the last column is its smallest resolvable step.")
    A("  %-26s %8s %9s %9s  %s"
      % ("instrument", "FS psi", "of FS", "1% of FS", "note"))
    sig = pp_pa
    for nm, fs_psi, note in RANGES:
        fs = fs_psi * PSI
        A("  %-26s %8.3f %8.2f%% %8.1f  %s"
          % (nm, fs_psi, 100.0 * sig / fs, fs / MMHG * 0.01, note))
    A("  -> A 0-30 psi gauge cannot see this pulse at all: one percent of its")
    A("     scale is %.0f mmHg against a %.0f mmHg signal."
      % (30.0 * PSI / MMHG * 0.01, pp_pa / MMHG))
    A("     Note the standpipe row too. An UNTHROTTLED standpipe is over range")
    A("     on the pulse, which is a polite way of saying it would spit fluid")
    A("     out of its open top once a second: the pulse alone is %.0f mm of"
      % head_mm(pp_pa))
    A("     fluid against a %.0f mm tank. Second reason for the capillary."
      % TANK_MM)
    A("")

    # ----------------------------------------------------------- bandwidth
    for frac, lab in ((0.95, "95"), (0.99, "99"), (0.999, "99.9")):
        k = int(np.searchsorted(cum, frac))
        A("  %s%% of the commanded flow's power is below %.0f Hz (harmonic %d)"
          % (lab, f[k], k))
    k99 = int(np.searchsorted(cum, 0.99))
    A("  -> sensor bandwidth %.0f Hz minimum, sample at %.0f Hz or better."
      % (f[k99], 10 * f[k99]))
    A("     That is easy for any MEMS part and impossible for a dial gauge,")
    A("     whose needle takes about a second to settle. The dial is not a")
    A("     cheap version of the transducer. It measures a different thing.")
    A("")

    # ----------------------------------------------------------- standpipe
    A("DOES THE MANOMETER REPLACE P1 AND P2")
    A("  No, and not because of accuracy. The three of them measure three")
    A("  different things and only one pair overlaps at all.")
    A("")
    A("  %-14s %-22s %s" % ("", "measures", "and would be missed because"))
    A("  %-14s %-22s %s"
      % ("manometer", "the MEAN, at the tee",
         "it sets R1. 1 - reading/jar IS"))
    A("  %-14s %-22s %s" % ("", "", "the forward fraction, and nothing"))
    A("  %-14s %-22s %s" % ("", "", "else reads that at all"))
    A("  %-14s %-22s %s"
      % ("P2", "the WAVEFORM at the",
         "it is the deliverable. The shape"))
    A("  %-14s %-22s %s" % ("", "block's inlet", "that reaches the phantom is what"))
    A("  %-14s %-22s %s" % ("", "", "the whole rig exists to produce"))
    A("  %-14s %-22s %s"
      % ("P1", "the WAVEFORM before",
         "it is the only thing that can tell"))
    A("  %-14s %-22s %s" % ("", "the plenum", "a bad P2 from a bad PISTON"))
    A("")
    A("  The manometer cannot stand in for either transducer, because it is")
    A("  deliberately throttled to 0.05 Hz so it CANNOT follow the pulse.")
    A("  That is not a shortcoming, it is what makes it a clean mean.")
    A("")
    A("  AND P1 IS LESS OPTIONAL THAN IT LOOKS, for a reason that is not the")
    A("  one in the phase-0 document. That document wanted two sensors to")
    A("  measure the plenum's attenuation in one run instead of moving one")
    A("  sensor and re-running, which was right for a drifting peristaltic.")
    A("  With a commanded piston the better argument is different:")
    A("")
    A("  THE STEP COUNTER IS OPEN LOOP. It reports what the firmware asked")
    A("  for, not what the fluid did. If the syringe leaks past its seal, or")
    A("  air gets into the barrel, or the plunger creeps in the rod clamp,")
    A("  every count is still perfect and every volume this file quotes is")
    A("  quietly wrong. The entire lost-motion effort in syringe_drive, the")
    A("  anti-backlash nut and the rod clamp, exists because displacement")
    A("  can be lost between the motor and the fluid. P1 is the only")
    A("  instrument on the bench that would see it happen.")
    A("")
    A("  IF ONE HAS TO GO it is P1, and you keep the manometer and P2: the")
    A("  manometer to set the loop, P2 to measure the thing being delivered.")
    A("  But P1 is thirty-five dollars against a rig nobody has run, and the")
    A("  failure it catches is invisible to everything else.")
    A("")

    A("WHAT THE MANOMETER IS MADE OF")
    A("  THREE PARTS, ALL OF THEM AT ONCE. Not a choice between them.")
    A("")
    A("    1. a clear vinyl tube, 6.35 mm bore, 1.3 m long")
    A("    2. a metre stick, with the tube taped along it")
    A("    3. a 16 gauge blunt luer needle, between the tube and the loop")
    A("")
    A("  Assembled: the needle tees into the trunk at the piston junction,")
    A("  the tube rises from it, the metre stick holds the tube straight and")
    A("  gives you something to read against. Total cost under ten dollars")
    A("  and there is nothing to calibrate.")
    A("")
    A("  Everything below is why those three numbers and not others. The")
    A("  tables are the WORKING, not a menu.")
    A("")
    A("  CLEAR, obviously, since the meniscus is the reading. Which rules out")
    A("  the RO kit's own tube: it is white LLDPE and you cannot see a level")
    A("  through it. Clear vinyl from a hardware store is the easy answer.")
    A("")
    A("  AND SOFT IS FINE HERE, which is worth saying out loud because every")
    A("  other run in this loop forbids it. The manometer carries no flow and")
    A("  sits behind a restriction, so its compliance never reaches the pulse")
    A("  and there is nothing for a soft wall to steal. It only has to be")
    A("  straight and vertical, which a strip of tape and a metre stick do.")
    A("")
    A("  CAN IT BE WIDER AND SHORTER? Wider, yes, and it changes nothing.")
    A("  Shorter, yes, and only one way.")
    A("")
    A("  WIDER DOES NOTHING TO THE HEIGHT. The column stands at h = p/(rho g)")
    A("  and there is no diameter in that expression. A 50 mm tube stands at")
    A("  exactly the same %.0f mm as a 6 mm one and holds 795 mL instead of"
      % 405.0)
    A("  13. Width buys a slightly easier meniscus and nothing else, which is")
    A("  the nature of the instrument rather than a limitation of this one.")
    A("")
    A("  SHORTER COMES FROM THE RANGE, NOT THE BORE. The 1.3 m was sized for")
    A("  the fault case, a shut R2 with no flow, which is the only thing that")
    A("  sends it to the jar's full height. The WORKING range is much")
    A("  narrower, because only R2 moves during the sweep:")
    A("  %-18s %16s" % ("R2 at", "manometer reads"))
    for r2, rd in ((0.0, 236.0), (50.0, 286.0), (169.0, 405.0),
                   (300.0, 536.0), (400.0, 636.0)):
        A("  %-18s %13.0f mm"
          % ("%.0f mm of head" % r2, TANK_MM * rd / (795.0 + rd)))
    A("  %-18s %13.0f mm   the fault case" % ("shut, no flow", TANK_MM))
    A("")
    A("  So 275 to 535 mm covers every setting the sweep will ever ask for.")
    A("  BUILD IT 700 mm AND RETURN ITS TOP TO THE RESERVOIR. That covers the")
    A("  working range with margin, and if someone does shut R2 the tube")
    A("  fills and spills back into the reservoir instead of onto the bench.")
    A("  Nothing is lost, the reading pins at 700 which tells you immediately")
    A("  that something is wrong, and the tube becomes a pressure cap as")
    A("  well. 700 mm instead of 1300, for the price of one more hose.")
    A("")
    A("  THE OTHER WAY IS A DENSER FLUID in a U-tube, and it is not worth it")
    A("  here. Height scales as the density ratio:")
    for nm, rho in (("the loop fluid", 1037.0), ("Fluorinert FC-40", 1855.0),
                    ("galinstan", 6440.0), ("mercury", 13534.0)):
        A("    %-20s %5.0f kg/m3 -> %4.0f mm for the 1200 mm case"
          % (nm, rho, 1200.0 * RHO / rho))
    A("  Mercury is out of the question in a student lab. Galinstan is")
    A("  non-toxic and about five dollars a gram. Fluorinert barely helps.")
    A("  All three add an immiscible interface to read instead of a clean")
    A("  meniscus, on an instrument whose entire appeal is that it has")
    A("  nothing in it. The 700 mm tube with an overflow is the answer.")
    A("")
    A("  TALL ENOUGH TO NOT OVERFLOW, and the number is not the working")
    A("  pressure. If R2 is ever closed the flow stops, and with no flow")
    A("  there is no loss anywhere, so the tube rises to the JAR's own")
    A("  height: %.0f mm. Build it %.1f m and it can never spill, whatever"
      % (TANK_MM, (TANK_MM + 100.0) / 1000.0))
    A("  anyone does to the clamps. Shorter and the first mistake costs a")
    A("  litre of blood-mimicking fluid on the bench.")
    A("")
    A("  WHY 6.35 mm BORE. It trades capillary rise against dead volume:")
    A("  %-12s %13s %13s %11s"
      % ("bore", "capillary rise", "if surfactant", "holds, mL"))
    for d in (3.0, 4.0, 6.35, 10.0):
        r = d * 1e-3 / 2.0
        A("  %-12s %10.1f mm %10.1f mm %10.0f"
          % ("%.2f mm" % d, 2 * 0.072 / (RHO * G * r) * 1e3,
             2 * 0.035 / (RHO * G * r) * 1e3,
             math.pi * r * r * 1.3 * 1e6))
    A("  The fluid climbs the walls by itself, a few mm, more in a narrow")
    A("  tube. But that is a fixed OFFSET, not a scale error, so zeroing the")
    A("  ruler against a known level removes it completely. 6.35 mm is the")
    A("  sensible pick: a few mm of rise and 41 mL of dead fluid.")
    A("")
    A("  ZERO IT AT THE RESERVOIR'S SURFACE, not at the bench or the block.")
    A("  That is the datum the whole head budget is written against, so a")
    A("  ruler zeroed there reads budget numbers directly with no arithmetic.")
    A("")
    A("  WHY 16 GAUGE. A blunt dispensing needle is luer, so it mates the")
    A("  adapters already on the list, and its bore is a known number:")
    A("  %-20s %9s %10s" % ("25 mm blunt needle", "ID mm", "settles in"))
    _c = math.pi * (6.35e-3 / 2) ** 2 / (RHO * G)
    for g, idd in (("14 gauge", 1.60), ("16 gauge", 1.19),
                   ("18 gauge", 0.84), ("20 gauge", 0.60)):
        _r = 128 * MU * 0.025 / (math.pi * (idd * 1e-3) ** 4)
        A("  %-20s %9.2f %7.0f s" % (g, idd, 3.0 * _r * _c))
    A("  Every one of them is 'reads the mean and cannot follow the pulse',")
    A("  so the choice is about patience, not correctness. 16 gauge settles")
    A("  in under 20 s, and bring-up is two knobs against two readings over")
    A("  several passes, so 20 s is the difference between a short afternoon")
    A("  and a long one. 18 gauge if that is what is in the drawer.")
    A("")

    A("THE STANDPIPE: IT READS IN BMF, NOT WATER")
    A("  GROUP-2_phase0-bench-rig.md already argues for the column and argues")
    A("  it well: a primary standard accurate to however well you read a tape")
    A("  measure, which is what you calibrate the transducer's offset and")
    A("  span against rather than trusting a 2.5 percent datasheet.")
    A("")
    A("  One correction to the table in it. It converts at 13.6 mm per mmHg,")
    A("  which is WATER. The column will be full of blood-mimicking fluid at")
    A("  %.0f kg/m3, and that converts at %.2f mm per mmHg."
      % (RHO, MMHG / (RHO * G) * 1e3))
    A("  %-18s %12s %12s" % ("column height", "if water", "if BMF"))
    for mm in (100.0, 500.0, 1000.0, TANK_MM):
        A("  %-18s %9.1f mmHg %9.1f mmHg"
          % ("%.0f mm" % mm, mm / 13.6, mm / (MMHG / (RHO * G) * 1e3)))
    A("  The gap is %.1f percent, so reading a BMF column off a water table"
      % (100.0 * (13.6 / (MMHG / (RHO * G) * 1e3) - 1.0)))
    A("  underreads by about %.0f mmHg at the top of the range. That is the"
      % (TANK_MM / (MMHG / (RHO * G) * 1e3) - TANK_MM / 13.6))
    A("  same size as the transducer error the column exists to correct, so")
    A("  it would quietly undo the calibration it was brought in to do.")
    A("")

    A("AND WHY IT HAS TO BE THROTTLED")
    col = TANK_MM * 1e-3
    fn = math.sqrt(2.0 * G / col) / (2.0 * math.pi)
    A("  A clear vertical tube teed into the line reads mean pressure in")
    A("  millimetres of the very fluid the head budget is written in. No")
    A("  calibration, no drift, no range problem. But a free liquid column is")
    A("  an oscillator: f = sqrt(2g/L)/2pi, and at L = %.0f mm that is" % TANK_MM)
    A("  %.2f Hz against a %.1f Hz beat. It would resonate with the piston."
      % (fn, BEAT_HZ))
    A("")
    cap = (math.pi * (6.35e-3 / 2) ** 2) / (RHO * G)     # m3/Pa, free surface
    for fc in (0.05, 0.10):
        tau = 1.0 / (2.0 * math.pi * fc)
        r = tau / cap
        L = r * math.pi * (1.0e-3) ** 4 / (128.0 * MU)
        A("  Throttle it to %.2f Hz: tau %.1f s, which is %.0f mm of 1.0 mm"
          % (fc, tau, L * 1e3))
        A("    bore capillary ahead of the standpipe. Reads the mean in about")
        A("    %.0f s and cannot follow the pulse, which is the point." % (3 * tau))
    A("")

    # ------------------------------------------------------- the dead leg
    A("THE SENSING DEAD LEG, IF THE TRANSDUCER IS NOT WETTED")
    A("  Most low-range MEMS parts have bare silicon behind the port and are")
    A("  not liquid compatible. The usual dodge is a short stub of trapped")
    A("  air between the line and the sensor. It works, and it is a gas")
    A("  spring sitting in the pulse path, so it has to be priced:")
    A("  %-22s %10s %10s" % ("air column", "mL stored", "% of stroke"))
    for d, L in ((3.0, 10.0), (3.0, 20.0), (3.0, 40.0), (1.5, 20.0)):
        v = math.pi * (d * 1e-3 / 2) ** 2 * L * 1e-3
        dv = v / 101325.0 * pp_pa                  # isothermal, dV = V dp / P
        A("  %-22s %10.4f %10.2f"
          % ("%.1f mm x %.0f mm" % (d, L), dv * 1e6, 100.0 * dv / stroke_m3))
    A("  -> keep it short and narrow, or buy a wetted sensor. 40 mm of 3 mm")
    A("     bore costs as much stroke as all the tubing put together.")
    A("")

    # ----------------------------------------------------------- velocity
    A("VELOCITY: THREE LAYERS, AND ONLY ONE OF THEM IS A SENSOR")
    A("")
    A("  1. THE MEAN, by weighing. Gravity sets it and nothing commands it,")
    A("     so it has to be measured. At %.0f mL/min the loop delivers" % Q_MEAN)
    A("     %.0f g/min. A %.0f g scale over 60 s is %.2f%% resolution, which"
      % (Q_MEAN * RHO * 1e-3, SCALE_G, 100.0 * SCALE_G / (Q_MEAN * RHO * 1e-3)))
    A("     beats any inline flow sensor that fits a 3 mm line.")
    A("     mean velocity in the lumen = Q / A = %.1f cm/s at %.0f mL/min."
      % (q_mean_si / (math.pi * (1.5e-3) ** 2) * 100.0, Q_MEAN))
    A("")
    A("  2. THE PULSE, by construction. %.3f uL per microstep, %d steps per"
      % (S.SCREW_LEAD / 1600.0 * S.BORE_A, round(S.BEAT_MM * 200)))
    A("     beat, counted in PIO hardware. Peak flow %.0f mL/min on top of the"
      % (q.max() * 6e7))
    A("     mean, so %.0f mL/min at peak systole. No sensor on this bench"
      % (q_peak * 6e7))
    A("     reports that better than the step counter already does. Do not")
    A("     buy an instrument to measure a number you command.")
    A("")
    A("  3. AN INDEPENDENT CHECK, once, during bring-up. A single bubble in")
    A("     the clear %.0f mm settling run, filmed at %.0f fps: at %.0f cm/s"
      % (CLEAR_RUN_MM, PHONE_FPS,
         q_mean_si / (math.pi * (1.5e-3) ** 2) * 100.0))
    A("     it crosses in %.0f ms, which is %.0f frames. Enough to measure to"
      % (1e3 * CLEAR_RUN_MM * 1e-3 / (q_mean_si / (math.pi * (1.5e-3) ** 2)),
         PHONE_FPS * CLEAR_RUN_MM * 1e-3 / (q_mean_si / (math.pi * (1.5e-3) ** 2))))
    A("     a few percent on a phone. Then purge it: bubbles are enormous")
    A("     Doppler scatterers and they quietly change loop compliance.")
    A("")

    # ---------------------------------------------------------- the PI check
    # The loop exists to put a plausible MCA waveform under a probe, and PI
    # is the number the whole programme is judged on, so it is worth reading
    # off the commanded trace before any hardware is bought.
    qt = (q + q_mean_si) * 6e7
    pi = (qt.max() - qt.min()) / qt.mean()
    A("THE PULSATILITY INDEX THIS LOOP WOULD PRODUCE")
    A("  Lumen area is fixed, so PI from flow is PI from velocity.")
    A("  peak %.0f mL/min, trough %.0f, mean %.0f  ->  PI = %.2f"
      % (qt.max(), qt.min(), qt.mean(), pi))
    A("  in velocity: %.0f / %.0f / %.0f cm/s"
      % (qt.max() * 1e-6 / 60 / (math.pi * 1.5e-3 ** 2) * 100,
         qt.min() * 1e-6 / 60 / (math.pi * 1.5e-3 ** 2) * 100,
         qt.mean() * 1e-6 / 60 / (math.pi * 1.5e-3 ** 2) * 100))
    A("")
    A("  Diastolic flow never reverses, which is right for an MCA. But a")
    A("  normal MCA sits near PI 0.8 to 1.2 and this is %.2f, so as specified" % pi)
    A("  the loop is TOO pulsatile. That is not a fault in the piston, which")
    A("  is doing exactly what it was told. It is the compliance plenum doing")
    A("  nothing yet, because nobody has sized it: its whole job is to shave")
    A("  the peak and hold diastole up, and it is the only element in the")
    A("  loop that moves PI without touching the stroke volume.")
    A("  Sizing it is the next piece of work on the loop, and it should be")
    A("  done against this trace rather than by eye.")
    A("")

    # --------------------------------------------------- the relief problem
    tq = S.MOTOR_TH * (S.SET_I / S.MOTOR_I)
    force = 2.0 * math.pi * tq * 0.30 / (S.SCREW_LEAD * 1e-3)
    stall = force / (S.BORE_A * 1e-6)
    A("THE RELIEF PATH, WHICH IS NOT A STANDPIPE")
    A("  The piston can overpressure the block. At %.3f A it makes about"
      % S.SET_I)
    A("  %.2f Nm, and through a Tr8x8 at 30%% efficiency that is %.0f N on a"
      % (tq, force))
    A("  %.0f mm2 bore: %.0f psi, %.0f mmHg, if the outlet is ever blocked."
      % (S.BORE_A, stall / PSI, stall / MMHG))
    A("  That is twenty times the working pressure and it would destroy a")
    A("  cast gel block.")
    A("")
    A("  But the relief CANNOT be an open standpipe teed into the pulse path.")
    A("  A standpipe's cracking pressure is zero, so the pulse would go up it")
    A("  in preference to going through a %.0f mm head of phantom. The relief"
      % (TANK_MM / 2.0))
    A("  has to be a valve that stays SHUT at working pressure and opens")
    A("  above it: set between about %.1f psi and Group 1's measured tear-out"
      % (2.0 * head_pa(TANK_MM) / PSI))
    A("  pressure, which they still owe. An open standpipe belongs upstream")
    A("  of the check valve, where it caps the gravity leg and the pulse")
    A("  cannot reach it.")
    A("")

    # ------------------------------------------- the modules already in hand
    A("THE CHEAP SINGLE-INLET MODULES, AND WHAT THEY CAN HONESTLY DO")
    A("  This was already worked out. capstone/GROUP-2_phase0-bench-rig.md")
    A("  has it under 'The trap at this price point', and reaches the same")
    A("  number from the same argument: at 40 SPS a beat gets about four")
    A("  samples on the systolic upstroke, the dicrotic notch smears away,")
    A("  and anything above 20 Hz aliases. 'Resolution is not the")
    A("  specification that matters here. Bandwidth is.' Redone below from")
    A("  scratch, which was a waste, and left in only because this file is")
    A("  where the beat's own spectrum lives.")
    A("")
    A("  A single inlet means GAUGE, referenced to the air around it, which is")
    A("  the right reference for this loop. So those are not the wrong idea.")
    A("  Their range is usually right too: the common MPS20N0040D module is")
    A("  0-40 kPa and the peak here is %.1f kPa, 23 percent of scale, which is"
      % ((head_pa(TANK_MM - crack_mm - up_mm) + pp_pa) / KPA))
    A("  the same place on the dial as the Honeywell part.")
    A("")
    A("  The bottleneck is the ADC bolted to the sensor, not the sensor. An")
    A("  HX710-class front end runs at tens of samples per second, and the")
    A("  feature this phantom exists to reproduce is a %.0f ms systolic"
      % (S.UPSTROKE_S * 1e3))
    A("  upstroke. Count samples across THAT, not samples per second:")
    A("  %-12s %12s %11s %s"
      % ("output rate", "across the", "Nyquist vs", "what it can honestly do"))
    A("  %-12s %12s %11s" % ("", "upstroke", "%.0f Hz" % f[k99]))
    for rate, note_ok, note_no in (
            (10.0, "mean only", "ten samples a beat is not a waveform"),
            (40.0, "PI, peak, trough", "upstroke rate and notch are guesswork"),
            (80.0, "PI and a usable shape", "notch is thin but there"),
            (110.0, "the spec in this file", "comfortable"),
            (200.0, "ABP2's rate", "nothing is left on the table")):
        n = rate * S.UPSTROKE_S
        ok = rate / 2.0 >= f[k99]
        A("  %-12.0f %12.0f %11s  %s"
          % (rate, n, "ok" if ok else "ALIASES",
             note_ok if n >= 8 else note_no))
    A("")
    A("  So the split is clean, and it is worth using rather than arguing with.")
    A("  PI is peak, trough and mean: three extrema, and extrema survive a")
    A("  coarse sample rate because they are flat where you catch them. Shape")
    A("  is the upstroke slope and the dicrotic notch, and those are exactly")
    A("  what a slow ADC destroys. A 40 SPS module will set R2 and size the")
    A("  plenum against PI perfectly well. It will not tell you whether the")
    A("  systolic upstroke is right, and that is the thing the whole phantom")
    A("  is for.")
    A("")
    A("  THREE NUMBERS TO CHECK ON THE ONES ALREADY IN HAND:")
    A("    1. output rate in samples per second. Under about 80 and it reads")
    A("       PI but not shape. Under about 20 and it reads the mean only.")
    A("    2. full scale. 0-40 kPa is ideal. A 0-100 psi water sensor puts the")
    A("       whole experiment in the bottom 1.3 percent of its range.")
    A("    3. media. These are almost always 'non-corrosive gas' parts with a")
    A("       bare die, so they need the air dead leg priced above. Keep it")
    A("       under 20 mm of 1.5 mm bore and it costs 0.4 percent of stroke.")
    A("")
    A("  Recommendation: use what is already on the shelf for bring-up and for")
    A("  the compliance and resistance sweep, because PI is what that sweep")
    A("  measures and a cheap module measures PI. Buy the ABP2 when the")
    A("  question becomes whether systole has the right shape.")
    A("")

    A("WHAT TO SPECIFY")
    A("  pressure, mean      clear vertical tube, 1/4 in, open top, scaled in")
    A("                      mm, behind a %.0f mm x 1 mm capillary. Doubles as"
      % (1.0 / (2 * math.pi * 0.05) / cap * math.pi * 1e-12 / (128 * MU) * 1e3))
    A("                      the gravity leg's pressure cap if put upstream")
    A("                      of the check valve.")
    peak_kpa = (head_pa(TANK_MM - crack_mm - up_mm) + pp_pa) / KPA
    A("  pressure, waveform  MEMS, gauge referenced, 0-20 kPa (0-3 psi) full")
    A("                      scale. The tee sees %.1f kPa of mean and %.1f kPa"
      % (head_pa(TANK_MM - crack_mm - up_mm) / KPA, pp_pa / KPA))
    A("                      of pulse on top, so peak is %.1f kPa: a 0-7 kPa"
      % peak_kpa)
    A("                      part, which looks right for the pulse alone, is")
    A("                      over range before the pulse even starts.")
    A("                      %.0f Hz bandwidth or better, digital output" % f[k99])
    A("                      preferred. Wetted or gel-filled if it can be had;")
    A("                      otherwise a dead leg under 20 mm of 1.5 mm bore.")
    A("  the part            MPX5050GP, and it was already chosen. It is in")
    A("                      capstone/GROUP-2_phase0-bench-rig.md with the")
    A("                      reasoning attached, including BUY TWO, one each")
    A("                      side of the compliance chamber, which is P1 and")
    A("                      P2 under different names. 0-50 kPa gauge, single")
    A("                      port, vented internally, about 1 ms response, so")
    A("                      bandwidth is not close to a problem. Peak here is")
    A("                      %.1f kPa, 19 percent of its scale."
      % ((head_pa(TANK_MM - crack_mm - up_mm) + pp_pa) / KPA))
    A("                      GP not DP: on the dual-port part only the P1 face")
    A("                      carries the gel and P2 is bare silicon, so there")
    A("                      is a wrong hole to plumb fluid into. The GP has no")
    A("                      wrong hole.")
    A("  its media status    honest version: the port face carries")
    A("                      fluorosilicone gel over the die and bonds, which")
    A("                      is what protects it, but NXP qualifies the part on")
    A("                      DRY AIR and refers media questions to the factory.")
    A("                      So it is gel-protected and not liquid-RATED. A")
    A("                      short air dead leg removes the question for 0.4")
    A("                      percent of stroke, and is what I would do.")
    A("  if you want it      Honeywell ABP2DANT005PG2A3XX is explicitly 'liquid")
    A("  liquid-rated        media, food-grade silicone gel' in the fourth")
    A("                      letter of the part number, I2C, 200 Hz, no dead")
    A("                      leg needed. Both sensors land on address 0x28 so")
    A("                      they need the Pico's two I2C buses. Better part,")
    A("                      and not better enough to override one that is")
    A("                      already specified in a document the teams hold.")
    A("  flow, mean          beaker and a 1 g kitchen scale, 60 s catches.")
    A("  flow, pulse         already known. The step counter is the instrument.")
    A("  relief              cracking-pressure valve above %.1f psi, not a"
      % (2.0 * head_pa(TANK_MM) / PSI))
    A("                      standpipe, and not in the pulse path.")

    # -------------------------------------------------------------- figure
    fig, ax = plt.subplots(1, 2, figsize=(12.0, 4.4), dpi=170)
    fig.patch.set_facecolor("white")

    a0 = ax[0]
    a0.plot(t, (q + q_mean_si) * 6e7, color="#b4462e", lw=2.0,
            label="total through the phantom")
    a0.axhline(Q_MEAN, color="#2e6fb4", lw=1.6, ls="--",
               label="gravity mean, %.0f mL/min" % Q_MEAN)
    a0.axhline(0.0, color="#999", lw=0.8)
    a0.fill_between(t, Q_MEAN, (q + q_mean_si) * 6e7,
                    where=((q + q_mean_si) * 6e7 > Q_MEAN),
                    color="#b4462e", alpha=0.15)
    a0.set_xlabel("time, s")
    a0.set_ylabel("flow, mL/min")
    a0.set_title("What the loop delivers: gravity sets the mean,\n"
                 "the piston adds the pulse", fontsize=10.5)
    a0.legend(fontsize=8, frameon=False)

    a1 = ax[1]
    k = min(len(f) - 1, 26)
    a1.stem(f[1:k], amp[1:k] / amp[1:k].max(), basefmt=" ",
            linefmt="#6b4aa0", markerfmt="o")
    a1.axvline(f[k99], color="#b4462e", lw=1.6, ls="--")
    a1.text(f[k99] + 0.4, 0.75, "99 %% of power\nbelow %.0f Hz" % f[k99],
            fontsize=8.5, color="#b4462e")
    a1.set_xlabel("frequency, Hz")
    a1.set_ylabel("amplitude, normalised")
    a1.set_title("Harmonics of the commanded flow:\n"
                 "this is the sensor bandwidth spec", fontsize=10.5)

    for a in ax:
        a.grid(alpha=0.25, lw=0.6)
        for s_ in ("top", "right"):
            a.spines[s_].set_visible(False)
    fig.text(0.5, 0.012,
             "The pulsatile term is commanded, not measured. The instruments "
             "exist to catch the mean and to prove the pulse survived the plumbing.",
             fontsize=8.3, color="#555", ha="center")
    fig.tight_layout(rect=(0, 0.045, 1, 1))
    fig.savefig(os.path.join(HERE, "instrumentation.png"), facecolor="white")
    A("")
    A("wrote instrumentation.png")


if __name__ == "__main__":
    main()
