kevin-horrigan/tcd-phantom/flow/pico_install.py

# -*- coding: utf-8 -*-
"""Put the motor driver onto a connected Pico. Runs on whatever laptop the
board is plugged into, not on the Pico.

    python pico_install.py                 find the board, upload, verify
    python pico_install.py --port COM15    pick the board explicitly
    python pico_install.py --help          this text, and nothing else
    python pico_install.py --test          upload, then half a shaft turn

Uploads pico/config.py and pico/drive.py, then imports drive on the board and
reads its constants back, so "installed" means the firmware actually ran and
agreed with the model rather than two files having landed.

It does NOT move the motor unless you pass --test, because the board may be
wired to a driver with no motor on it, or to a motor with a syringe already
in the carriage. Moving a stepper is never the safe default.
"""
import os
import sys

import picolink

HERE = os.path.dirname(os.path.abspath(__file__))
FILES = ("config.py", "drive.py")
# Uploaded when present. net.py is harmless on a non-W board, it just cannot
# be imported there. secrets.py is gitignored and may legitimately not exist.
OPTIONAL = ("net.py", "secrets.py")

# A verification import is sub-second work. exec defaults to 600 s because it
# also runs bench tests that go minutes between prints, and that default turned
# a board failing its import into a terminal that simply sat there. A timeout
# that long is indistinguishable from a hang, and the operator kills it before
# it ever reports. Short here, and the message says what it means.
VERIFY_WAIT = 25.0

WIFI_PROBE = """
try:
    import network
    print("WIFI|yes")
except ImportError:
    print("WIFI|no")
"""

CHECK = """
import drive, config as C
print("OK|%d|%.5f|%.5f|%.3f|%d|%d|%d|%d" % (
    C.STEPS_PER_MM, C.UL_PER_STEP, C.BEAT_MM, C.SOFT_TRAVEL_MM,
    len(C.BEAT), C.STEP_PIN, C.DIR_PIN, C.EN_PIN))
drive.off()
"""


FLAGS = {"--test": 0, "--port": 1, "--help": 0, "-h": 0}


def parse():
    """Strict. An unrecognised flag is an error, not something to ignore.

    This script once took --help as "do the install", because it scanned
    sys.argv for the flags it knew and ignored everything else. That is a bad
    bargain anywhere and an unacceptable one here: the same leniency means a
    mistyped --tset quietly does nothing while --test energises a stepper
    bolted to a syringe. A flag either means what it says or stops the run.
    """
    opts, i, av = {}, 1, sys.argv
    while i < len(av):
        a = av[i]
        if a not in FLAGS:
            raise SystemExit("unknown argument: %s\n\n%s" % (a, __doc__))
        if FLAGS[a]:
            if i + 1 >= len(av):
                raise SystemExit("%s needs a value\n\n%s" % (a, __doc__))
            opts[a] = av[i + 1]
            i += 2
        else:
            opts[a] = True
            i += 1
    if "--help" in opts or "-h" in opts:
        print(__doc__)
        raise SystemExit(0)
    return opts


def main():
    opts = parse()
    for f in FILES:
        p = os.path.join(HERE, "pico", f)
        if not os.path.exists(p):
            raise SystemExit(
                "missing %s. Run: python gen_pico_config.py" % p)

    port = opts.get("--port") or picolink.find_port()
    print("board on %s" % port)

    pico = picolink.Pico(port)
    try:
        pico.enter_raw()
        out, err = pico.exec("import sys\nprint(sys.implementation)",
                             wait=VERIFY_WAIT)
        if err.strip():
            raise SystemExit("board refused a plain print:\n" + err)
        ver = out.strip()
        print("firmware %s" % ver)
        if "micropython" not in ver.lower():
            raise SystemExit("that is not MicroPython. See pico/README.md.")

        for f in FILES:
            name, n = pico.put(os.path.join(HERE, "pico", f), f)
            print("  uploaded %s, %d bytes" % (name, n))
        for f in OPTIONAL:
            src = os.path.join(HERE, "pico", f)
            # A placeholder secrets.py is worse than none: net.serve() then
            # fails at the radio with a wrong-password timeout, which is the
            # one failure that looks like a hardware problem.
            if f == "secrets.py" and os.path.exists(src):
                if "your-2.4GHz-network" in open(src, encoding="utf-8").read():
                    print("  skipped secrets.py, still the unedited template")
                    continue
            if os.path.exists(src):
                name, n = pico.put(src, f)
                print("  uploaded %s, %d bytes" % (name, n))
            else:
                print("  skipped %s, not present locally" % f)

        # Wifi is a firmware question, not a software one, so answer it here
        # rather than letting net.py fail confusingly later.
        out, _ = pico.exec(WIFI_PROBE, wait=VERIFY_WAIT)
        wifi = "WIFI|yes" in out

        # Drop the module cache before importing, or this verifies a file
        # on disk while the board keeps running the version it replaced.
        pico.fresh()
        out, err = pico.exec(CHECK, wait=VERIFY_WAIT)
        if err.strip():
            raise SystemExit("drive.py did not import cleanly:\n" + err)
        lines = out.strip().splitlines()
        line = [l for l in lines if l.startswith("OK|")]
        if not line:
            raise SystemExit("drive.py imported but said nothing:\n" +
                             "\n".join(lines))
        _, spmm, ulst, beat, soft, n, st, dr, en = line[0].split("|")
        print("")
        print("drive imported and answered:")
        print("  %s steps/mm, %s uL/step" % (spmm, ulst))
        print("  beat %s mm = %d steps" % (beat, round(float(beat) * float(spmm))))
        print("  soft limit %s mm, beat profile %s samples" % (soft, n))
        print("  pins STEP=%s DIR=%s EN=%s" % (st, dr, en))
        print("")
        if wifi:
            print("firmware has wifi. For wireless control, upload secrets.py")
            print("if you have not, then on the board: import net; net.serve()")
        else:
            print("NO WIFI in this firmware. This is the RPI_PICO2 build, which")
            print("has no CYW43 driver, so net.py cannot run no matter what.")
            print("If the board is a Pico 2 W, reflash with RPI_PICO2_W. See")
            print("pico/README.md section 6. A non-W build runs fine on W")
            print("hardware, which is why this looks like a software fault.")

        if opts.get("--test"):
            print("\n--- half a shaft revolution, then it STOPS. MARK THE SHAFT ---")
            pico.fresh()
            pico.exec("import drive" + chr(10) + "drive.selftest()",
                      stream=True)
        else:
            print("\nNothing has moved. When the motor is connected and VREF is")
            print("set to 0.53 V, run this again with --test, or on the board:")
            print("    import drive; drive.selftest()")
    finally:
        pico.close()


if __name__ == "__main__":
    main()
