kevin-horrigan/tcd-phantom/flow/bench_layout.py

# -*- coding: utf-8 -*-
"""The whole piston station on one sheet: what sits where, and what wires to what.

    python bench_layout.py      ->  bench-layout.png

Top panel is a true side elevation, every coordinate taken from syringe_drive so
it cannot drift from the model. Bottom panel is the electrical setup, not to
scale. Footprints that are known are drawn; the two that are not are marked
nominal rather than guessed.
"""
import os
import matplotlib
matplotlib.use("Agg")
import matplotlib.pyplot as plt
from matplotlib.patches import Rectangle, FancyArrowPatch, Circle
import syringe_drive as S

HERE = os.path.dirname(os.path.abspath(__file__))

PRINTED = "#4a6d8c"      # the three printed parts
METAL = "#8d8f93"        # rod, screw, bearing
MOTOR = "#b08c3a"
SYR = "#cfd6dc"
FLUID = "#1f8a70"
PWR = "#c0392b"
GND = "#2b2b2b"
SIG = "#2f6fb0"
INK = "#1b1b1b"
GREY = "#6c6c6c"


def rect(ax, x0, x1, z0, z1, fc, ec=None, lw=0.9, z=2, alpha=1.0):
    ax.add_patch(Rectangle((x0, z0), x1 - x0, z1 - z0, facecolor=fc,
                           edgecolor=ec or INK, linewidth=lw, zorder=z,
                           alpha=alpha))


def dim(ax, x0, x1, z, text):
    ax.annotate("", (x0, z), (x1, z),
                arrowprops=dict(arrowstyle="<->", color=GREY, lw=0.8), zorder=6)
    ax.text((x0 + x1) / 2, z + 1.8, text, ha="center", va="bottom",
            fontsize=7.4, color=GREY, zorder=6)


def tag(ax, x, z, text, tx, tz, color=GREY, size=7.6, ha="left"):
    ax.annotate(text, (x, z), (tx, tz), fontsize=size, color=color, ha=ha,
                va="center", zorder=8, linespacing=1.4,
                arrowprops=dict(arrowstyle="-", color=color, lw=0.6,
                                shrinkA=0, shrinkB=2))


# --------------------------------------------------------------- elevation
def elevation(ax):
    half = S.MOTOR_SQ / 2
    rib_top = 57.0

    ax.plot([-170, S.X_END + 74], [0, 0], color=GREY, lw=1.0, zorder=1)
    ax.text(-170, -7.0, "bench", fontsize=7.2, color=GREY)

    # the loose kit, same bench, to scale where the size is known
    rect(ax, -162, -67, 0, 30, "white", ec=GREY, lw=1.0, z=1)
    ax.text(-114.5, 15, "12 V brick\nnominal, measure yours", ha="center",
            va="center", fontsize=7.2, color=GREY, zorder=3)
    rect(ax, -62, -28, 0, 25, "white", ec=GREY, lw=1.0, z=1)
    tag(ax, -45, 25, "Pico + TMC2209 on the breakout.\n"
                     "Shelf holes are now in the frame,\n"
                     "the shelf itself is not drawn yet.",
        -168, 52)

    # printed frame: baseplate, motor plate, end rib
    rect(ax, S.X_MOTOR_FACE, S.X_END, 0, S.BASE_T, PRINTED)
    rect(ax, S.X_MOTOR_FACE, S.X_MOTOR_BACK, 0, S.SCREW_H + half, PRINTED)
    rect(ax, S.X_RIB, S.X_RIB_BACK, 0, rib_top, PRINTED)

    # pancake motor, hanging off the back of the plate in free air
    rect(ax, -23.0, S.X_MOTOR_FACE, S.SCREW_H - half, S.SCREW_H + half, MOTOR)
    ax.text(-11.5, S.SCREW_H, "17HE08\n1004S", ha="center", va="center",
            fontsize=6.6, color="white", zorder=5, fontweight="bold")

    # coupler, screw, 608
    rect(ax, S.X_MOTOR_BACK, S.X_MOTOR_BACK + S.COUPLER_L,
         S.SCREW_H - 9.5, S.SCREW_H + 9.5, "#5a5a5a")
    rect(ax, S.X_MOTOR_BACK, S.X_RIB_BACK, S.SCREW_H - 4, S.SCREW_H + 4, METAL)
    ax.add_patch(Circle((S.X_RIB + S.WALL_T / 2, S.SCREW_H), S.BEAR_OD / 2,
                        facecolor="#c8cbcf", edgecolor=INK, lw=0.9, zorder=4))

    # carriage: solid retracted, ghosted at full extension
    for x0, a, lbl in ((S.X_CARR_MIN, 1.0, "carriage, retracted"),
                       (S.X_CARR_MAX, 0.22, "fully extended")):
        rect(ax, x0, x0 + S.CARRIAGE_L, S.BASE_T, S.SYR_H + 8.0,
             PRINTED, z=5, alpha=a)
        ax.text(x0 + S.CARRIAGE_L / 2, S.BASE_T + 2.5, lbl, ha="center",
                va="bottom", fontsize=6.6, zorder=9,
                color="white" if a == 1.0 else GREY)

    # syringe: flange butts the rib, barrel through the slot, tip past the end
    rect(ax, S.X_RIB - S.SYR_FLANGE_T, S.X_RIB, S.SYR_H - 10, S.SYR_H + 10, SYR, z=6)
    rect(ax, S.X_RIB - S.SYR_FLANGE_T, S.X_TIP,
         S.SYR_H - S.SYR_BARREL_D / 2, S.SYR_H + S.SYR_BARREL_D / 2, SYR, z=6)
    rect(ax, S.X_TIP, S.X_TIP + 6, S.SYR_H - 2.2, S.SYR_H + 2.2, SYR, z=6)

    # plunger: disc held in the carriage pocket, rod back into the barrel
    xd = S.X_CARR_MIN + S.CARRIAGE_L - S.FRONT_W - S.DISC_T / 2
    rect(ax, xd, S.X_RIB - S.SYR_FLANGE_T, S.SYR_H - S.PLUNGER_ROD_D / 2,
         S.SYR_H + S.PLUNGER_ROD_D / 2, "#9aa6b1", z=7)
    rect(ax, xd - S.DISC_T / 2, xd + S.DISC_T / 2,
         S.SYR_H - S.DISC_D / 2, S.SYR_H + S.DISC_D / 2, "#7f8c99", z=8)

    # fluid: tip to a tee, up to the phantom, down to the gravity feed
    tx, tz = S.X_TIP + 6, S.SYR_H
    ax.plot([tx, tx + 22], [tz, tz], color=FLUID, lw=2.2, zorder=6)
    ax.plot([tx + 22, tx + 22], [tz - 16, tz + 22], color=FLUID, lw=2.2, zorder=6)
    ax.plot([tx + 22, tx + 36], [tz + 22, tz + 22], color=FLUID, lw=2.2, zorder=6)
    ax.plot([tx + 22, tx + 36], [tz - 16, tz - 16], color=FLUID, lw=2.2, zorder=6)
    ax.add_patch(Circle((tx + 22, tz), 2.8, facecolor="white", edgecolor=FLUID,
                        lw=1.6, zorder=7))
    ax.text(tx + 39, tz + 22, "to the phantom", fontsize=7.6, color=FLUID,
            va="center")
    ax.text(tx + 39, tz - 16, "gravity feed\nCHECK VALVE HERE", fontsize=7.6,
            color=FLUID, va="center", linespacing=1.4)

    tag(ax, 0, S.SCREW_H - half, "23 mm body, 180 g,\nhangs in free air",
        -8, -24, ha="right")
    tag(ax, S.X_MOTOR_BACK + 12, S.SCREW_H + 9.5, "5-8 mm flexible coupler",
        -20, 68)
    tag(ax, xd, S.SYR_H + S.DISC_D / 2,
        "closed pocket, so the carriage\npulls as well as pushes", 34, 80)
    tag(ax, S.X_RIB + S.WALL_T / 2, S.SCREW_H + 11, "608 low in the rib", 132, 58)
    tag(ax, S.X_RIB + 3, S.SYR_H + 10, "barrel slot high in the same rib",
        132, 76)
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
