kevin-horrigan/tcd-phantom/(commit log)

2026-09-11 Initial commit: capstone briefs, literature index, reference list
    Bench phantom for TCD validation, and the working repo for the GW BME
    senior design build behind it.
    Contents:
    - INDEX.md, annotated index of the phantom literature and what each item
    is for, plus the open design decisions
    - capstone/, four briefs across two student groups (materials and vessels,
    pulsatile loop, literature review guide, Phase 0 bench rig). Shared
    interface items and the December gate are mirrored verbatim across the
    group briefs so the two teams cannot work from different assumptions
    - refs/REFERENCES.md, DOI list with open-access status
    Literature PDFs are deliberately not committed. Most are under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
2026-09-29 Add interface control document: Group 1 owns the vessel
    Written in response to a direct question from Group 2 asking whether the
    tubing they select becomes the MCA, or whether the other group designs
    the vessel. The answer is that Group 1 owns the vessel and Group 2's
    tubing is plumbing that terminates at a fitting on the outside of the
    phantom block.
    The confusion is ours. The Phase 0 bench rig deliberately uses a tubing
    segment as its test vessel, which is right for a disposable requirements
    rig and wrong for the phantom, and most of the published literature also
    runs fluid through a suspended tube rather than a wall-less lumen. Both
    now stated explicitly.
    Includes the ownership boundary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
2026-09-29 Add Group 1 literature review guide
    Group 2 had a literature review guide from the start; Group 1 never got
    one, and has been working without a stated format. A student on Group 1
    asked what the format was after hearing the other team had one.
    Same structure and deliverable shape as the Group 2 guide so the two
    reviews sit side by side, but the subject is materials and the acoustic
    path rather than flow loops: tissue-mimicking families and what tunes
    their sound speed, skull analogs, wall-less vessel construction, and the
    measurement methods for sound speed and attenuation.
    Eleven questions, with the skull analog problem broken out as its own
    section because it is the hardest part and the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
2026-09-29 Reframe Group 1 notes as help rather than a second assignment
    The course sets the literature review requirements. These notes should
    add to that, not stack another set of deliverables on top of it, and the
    first draft read like an assignment: questions you must answer, the
    deliverable, a timeline I had no business setting.
    Rewritten as reading notes. The table is offered as a thing that makes
    the writing easier rather than a required artifact, the questions are
    framed as what the review is really about, the structure section defers
    to whatever the course wants, and the timing is their course deadline.
    Substance is unchanged.
    Two citations verified that had been written from memory rather t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
2026-09-29 Reframe Group 2 notes as help, and fold in what the first table taught
    Same change as the Group 1 notes: the course owns the assignment, so
    these are reading notes rather than a second set of deliverables. The
    table is described rather than demanded, since Group 2 has already built
    one, the structure section defers to the course, and timing is their
    course deadline.
    Substantive corrections folded in from reviewing their first table and
    from verifying citations:
    - IEC 61685:2001 specifies a test object carrying STEADY flow, so it
    does not govern waveform for a pulsatile phantom. It covers the
    tissue-mimicking material and blood-mimicking fluid specifications
    and nothing more. Stated i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
2026-09-29 Drop the signing requirement from the interface document
    The signature block, the unsigned marker in the header, and the not in
    force until both teams have signed line were all too formal for an
    undergraduate capstone, and they implied an approval gate nobody wanted.
    Replaced with a Keeping it current section saying plainly that this is a
    working file rather than a contract: update it as numbers settle, commit
    the change, and if something turns out to be wrong then change it and say
    why. Changing a spec now means talking to the other team first rather
    than agreeing in writing.
    Both group briefs previously said to freeze the items in a signed
    interface document in month one and listed inter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
2026-09-29 Renumber Rominger to 19, matching the number the team already assigned
    Reading the students' full working document showed they had already added
    Rominger themselves as article 19, written out the full citation, and
    assigned it to one person in their reading split. Adding it as 9b created
    a second label for the same paper, which is the exact problem the earlier
    numbering mess caused.
    Now listed as 19, out of sequence in the flow phantom section so nothing
    else shifts, with a line saying why it sits there.
    Their work plan divides all 19 articles across four people by number, so
    any renumbering breaks an individual's reading assignment, not just the
    citations. Worth remembering before touchin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
2026-11-10 Add the consolidated project description and team summaries
    Both are synced from the .docx files K. Horrigan formatted by hand on 2026-10-30, so
    the markdown is the readable copy and the .docx stays authoritative for layout.
    Also folds the wall-less decision into the open-questions list in INDEX.md: Group 1 is
    now proposing wall-less at 3 mm, which turns an either/or into a survival question
    gated on their tear-out number, and extends the interface document and the Phase 0
    bench rig brief to match.
2026-11-10 Add the parametric phantom block model, rev A
    Solid model of Group 1's block to the 2026-10-30 sizing: 60 mm ear to eye, 40 mm tall,
    100 mm deep, with the 60 mm face as the temporal window and the skull plate sliding in
    and out of it. Everything derives from the constants at the top of phantom_block.py, so
    one number changes the STL, the fit checks and the drawings together.
    verify.py is the part that matters: it checks the plate slides, the lumen mandrel
    clears, and the window seats, so a sizing change cannot quietly produce an
    unassemblable block. Ships the 2 to 10 mm skull plate pairs so the team can print the
    thickness sweep without running Python.
2026-11-10 Add the three loop figures as published pages and printed PDFs
    Loop layout, pulse generator and the pump-and-waveform explainer. The HTML is the
    source and the PDF is what travels in email and into a slide, so both are kept and
    re-printed together whenever a page is republished.
2026-11-10 Add the pulsatile piston drive: model, checks, print pipeline and bench tooling
    The waveform generator for Group 2's loop. syringe_drive.py is the parametric model
    and check_drive.py is the 32-check harness that gates it, and the harness is the point:
    it caught a saddle bore that would have locked out the 5 mL syringe forever, a rib that
    gave the 608 no shoulder, a motor plate that did not reach the rods, and a shelf hole
    2.0 mm from a strap slot. None of those were visible by eye in the render.
    The syringe bore is the master parameter. Moving from 3 mL to 5 mL halves peak speed to
    230 rpm because speed falls as the square of the bore, and that single change removed
    every motor difficulty i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
2026-11-10 Measure the syringe, and pin the frame to the part that was actually printed
    Six placeholders became measurements on the BH5LL. Three landed outside the
    guess by more than a tolerance, and each one cost something different.
    BORE_A 120.0 mm2 3000 / 25.0 mm, read 1 mL mark to 4 mL mark
    SYR_BARREL_D 14.0 mm estimated 12.5
    DISC_D 16.5 mm estimated 11.0
    PLUNGER_ROD_D 12.0 mm estimated 7.0
    SYR_BARREL_L 66.0 mm estimated 56.0
    DISC_T / SYR_FLANGE_T 2.0 mm each
    Three of them corroborate each other, which is the reason to trust them. A
    120.0 mm2 bore is 12.36 mm across; inside a 14.0 mm OD that is a 0.82 mm
    barrel wall, right for moulded polypropylene, and a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
2026-11-10 Stop the waveform depending on a thumb disc measurement
    The disc read 1.9 on a caliper, then 2.0 on another syringe, then 1.71 on a
    micrometer. The caliper was not scattering, it was overreading: on a thin
    moulded disc the jaws span the raised rim or sit a degree out of square, and
    both errors are one-signed. Two "different" discs were one instrument wrong
    by different amounts.
    That matters because the pocket capturing the disc was drawn at DISC_T + 0.4
    and prints 2.16 after the bridge droops. Around a real 1.71 disc that is
    0.45 mm of slack: 54 uL, 11 percent of the beat, and a flat spot of about
    20 ms on a 100 ms upstroke, landing exactly on the foot of systole.
    Nothing else in the drive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
2026-11-10 Add the interactive assembly viewer
    assembly.py places every part of the drive at its assembled position, names
    it, and emits web/assembly.json: base64 float32 vertices and uint32 faces per
    part, plus colour, explode offset, build step and the text of that step. The
    viewer in web/assembly.html loads it into three.js, so the page cannot drift
    from the model or from the STLs that were printed.
    Fourteen parts in build order, five of them printed and nine bought. The
    bought parts are drawn at catalogue size from the same constants the frame
    was cut around, which is deliberate: if the 608 pocket and the 608 ever
    disagree, they disagree here, visibly, instead of on the bench.
    The page also anima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
2026-11-10 Add the Pico motor driver, generated from the model
    The step generator existed only inside step_test.py as a bench test. This
    makes it a driver.
    pico/drive.py runs ON the Pico: PIO step train, exact position,
    soft limits, beat player
    pico/config.py GENERATED, never hand-edited
    gen_pico_config.py writes it from syringe_drive and assembly
    pico_install.py uploads to a connected board and verifies
    pico/README.md laptop setup, firmware, power-up order, failure modes
    config.py is generated because every number the firmware needs moves when the
    syringe changes. Retyping them is how a rig ends up commanding a 4.38 mm beat
    throu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
2026-11-10 Make the Pico tools refuse to guess, and stop --help from installing
    Two defects, both found by running the thing rather than reading it.
    --help ran the install. pico_install.py scanned sys.argv for flags it knew
    and ignored the rest, so an argument meaning "show me the usage" did the
    upload instead. That leniency is a bad bargain anywhere and an unacceptable
    one here, because the same rule means a mistyped --tset quietly does nothing
    while --test energises a stepper bolted to a syringe. Arguments are parsed
    strictly now: unknown flags stop the run, and --help prints and exits.
    find_port took the first VID 2E8A device. Three boards on this bench answer
    to that VID: the motor Pico, the Sent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
2026-11-10 Add wireless control, and stop picolink losing data without saying so
    Wireless, on the Pico 2 W the board turned out to be:
    pico/net.py HTTP server and control page, runs on the Pico
    pico/secrets_example.py template; secrets.py is gitignored, repo is public
    The server COMMANDS, it does not stream. You ask for thirty beats and the
    Pico plays thirty; nothing sends a waveform over wifi slice by slice, and the
    socket is polled between beats and never during one. A beat is 160 slices and
    at 60 bpm each is 6.25 ms, which is the window Python has to hand PIO its
    next burst, and servicing the CYW43 eats into exactly that window.
    What that would break is worth being precise about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
2026-11-10 Correct the VREF procedure: meter with VM ON, motor off
    pico/README.md and pico/drive.py both said to set VREF with 12 V OFF. That
    is wrong, and step_test.py has had the right sequence all along: motor
    disconnected, 12 V ON, meter on the VREF pin against GND.
    The error came from conflating "the motor must not be connected" with "the
    power must be off". Only the first is the safety rule. On a carrier that
    feeds the pot from the driver's own rail there is nothing to read without
    VM, and a reading of 0.00 V then looks exactly like a pot wound all the way
    down when it may be wound all the way up.
    Also records two things about the pot that were only in step_test.py:
    clockwise REDUCES current, b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
2026-11-10 Correct the pot direction and the VREF supply, both from measurement
    Two corrections from the bench, both of which overrule what this repo said.
    POT DIRECTION. On this BTT TMC2209 V1.3, CW RAISES VREF and CCW LOWERS it.
    Evidence: from 0.27 V a small CCW turn gave 0.00 V at a hard end stop, and
    from that stop CW ran up to 1.25 V. step_test.py said the opposite,
    "backward from an A4988, clockwise REDUCES current", inherited from what is
    commonly said about these carriers and never measured here.
    It was not a harmless error. A quarter turn CCW was read as having RAISED
    the current toward 1.6 A on a 1.0 A motor, and raised a false alarm, when it
    had lowered it and was harmless. The lesson is i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
2026-11-10 Make selftest one screw revolution, so it is a test and not a demo
    The motor is connected but the rods, screw, nut and bushes have not arrived,
    so the first run of drive.py is a bare shaft spinning free. The old selftest
    commanded 2 mm, which is a quarter turn: enough to see something happen and
    not enough to tell whether the right thing happened.
    It now defaults to SCREW_LEAD, exactly one revolution. Mark the shaft, run
    it, and the mark has to come back. "It moved" proves the wiring. "It moved
    exactly one revolution and returned" proves STEPS_PER_REV, MICROSTEP, the
    PIO period arithmetic and STEPS_PER_MM together, which is the entire chain
    between a millilitre in the model and a millilitre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
2026-11-10 Make selftest stop instead of returning, so it can actually detect the fault
    An out-and-back move cannot detect the microstep error it was written to
    catch. If microstepping is really 16 rather than the 8 the config assumes,
    the shaft turns half as far out and half as far back and returns to exactly
    where it started, looking perfect. The return leg cancels precisely the fault
    being hunted. The previous version was a demonstration dressed as a test, and
    the commit that introduced it claimed it would "catch it in ten seconds".
    Found by the session at the bench, before it was run.
    Watching a mid-move pause would work and was the first suggestion, but it
    hangs a correctness check on a human ca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
2026-11-10 Add drive.diag() to bisect a silent motor, and make a dead move loud
    The motor did not turn under selftest, with no error, on hardware that spun
    fine yesterday under step_test.py. The PIO program, the pins and the EN
    polarity are identical between the two, so this adds a way to find out where
    it stops rather than reason about it.
    drive.diag() narrows in three stages:
    1. What the pins read. EN low means the driver is enabled.
    2. Whether the PIO state machine consumes what it is handed. A FIFO that
    never drains means the step train was never generated, and nothing
    about the motor, the wiring or the supply is implicated yet.
    3. A step train bit-banged from Python with PIO swit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
2026-11-10 Stop a re-install silently running the code it replaced
    Uploading a file does not change what is already running. MicroPython caches
    imports in sys.modules for the life of the board session, so a module
    imported once before an upload stays imported after it.
    Measured at the bench today: a fresh drive.py went up, verified by hash, and
    the board then ran the PREVIOUS version's selftest, because an earlier eval
    had already imported it. The banner was new and the body was old.
    On a file full of motion limits that is not an inconvenience. You can tighten
    a soft travel limit, watch the upload verify against a sha256, and have the
    board go on enforcing the old one. Nothing about that failure look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
2026-11-10 Make the motor a table with a chooser, because one is about to be swapped
    Kevin is moving to the team's motor. Four loose constants became a table so
    that a swap is one line and everything downstream recomputes rather than
    being inherited: torque, the 12 V speed ceiling, the phase reversal margin,
    and whether the VREF already set on the pot is legal for the new motor.
    That last one is the reason for the change. VREF is NOT a property of the
    driver. 0.556 V was derived for the pancake, and the same pot setting on a
    different motor can be anywhere between comfortable and over its rated
    current. A motor swap is a current decision before it is a mechanical one.
    Four new checks enforce it agains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
2026-11-10 Refuse to step a disabled driver, and give bench tools a public jog
    back() went straight to _burst without enabling. selftest() ends with off(),
    so back() pushed pulses into a disabled driver: the shaft stayed put, pos
    advanced, and it printed "returned 0.50 revolutions". Found at the bench.
    That is the second time this exact shape has appeared here, after _burst
    returning 0 for an impossible rate. Patching back() would fix one caller.
    _burst now raises when the driver is disabled, which fixes every caller that
    will ever be written, including the ones not written yet. All four motion
    paths were audited: move_mm, beat, selftest and jog all enable.
    Adds jog(revs, rpm) so bench tools stop rea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
2026-11-10 Free the PIO program on reload, and stop a failed import looking like a hang
    The module-cache fix created this one. Dropping drive from sys.modules frees
    the Python objects but NOT the assembled PIO program, which stays loaded in
    PIO0's 32 instruction slots. Every reload added another copy of _step_n until
    rp2.StateMachine() raised ENOMEM and nothing moved. Found at the bench after
    two presses of a dial button.
    That is the ordinary shape of this work: one correctness fix uncovering the
    next. Reloading was impossible before, so the leak had nowhere to show.
    drive.py now stops SM 0 and clears PIO0 before building its state machine.
    The reclaim belongs there rather than in picolink's fresh(),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
2026-11-10 Record the ordered T8 nut and gate the carriage print on measuring it
    The nut on order is uxcell a24113000ux0399 / B0DSZ4YYFS: the POM spring
    loaded anti-backlash nut, not the brass one carriage() is cut for.
    Its listing settles the one number the firmware depends on, lead 8 mm with
    2 mm pitch and 4 start, which keeps 200 steps/mm and 0.600 uL/step. It never
    states the hole pattern, and its dimension block contradicts itself: "Nut
    Size: 15x14mm (L*W); 15x22x11mm (L*W*H)" with inch conversions fitting
    neither triple, and an attribute table calling the outside diameter 15 mm
    while the flange is 22.
    A bolt circle cannot be drawn loose the way SADDLE_BORE was, so there is no
    generous default t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
2026-11-10 Size the tank-to-phantom tubing, and put the settling run back in the budget
    Adds feed_tubing.py, which answers what bore the feed tubing should be by
    splitting the feed side into four zones and noting that the check valve is
    what separates them. The valve blocks the pulse from travelling back toward
    the tank, so the compliance of everything upstream of it is charged against
    nothing: only the tee-to-transition run and the 3 mm settling run can steal
    stroke volume.
    Three effects compete and they do not point the same way. Resistance goes as
    1/d^4 and wants big bore. Compliance goes as d^3/(E*h) and wants small bore
    and a stiff wall. Inertance goes as 1/d^2 and wants big bore but only delays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
2026-11-10 Name the real check valve part numbers; 9105x was a wildcard, not a part
    The BOM, the head budget and the tubing analysis all called for a "Qosina
    9105x" check valve. No such part exists. It was a family wildcard written
    into these notes and never expanded, and a search for it returns nothing,
    which is exactly what it did to the person trying to buy one.
    The barbed high-flow family is four parts: 91050 for 1/4 in ID tubing at
    0.075 psi, 91054 for 3/16 in at 0.055, 91053 for 1/8 in at 0.061, and 91055
    for 3/8 in at 0.072. The trunk is 1/4 in, so the part is 91050.
    The 0.029 psi figure these notes flagged as a vendor contradiction was not
    one. It belongs to 91052, a push-on port for 1/8 in O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
2026-11-10 Draw the printed ball check, and fix the ball-and-seat pairing
    Answers the question the valve raised: no, it does not fit inside the
    tubing, and neither does the part it replaces. A ball cannot live in 1/4 in
    tubing because the ball is 6.35 mm and so is the bore, and even a smaller
    ball would seal the tube the instant it lifted. Every ball check is an inline
    body with a chamber wider than the ball. This one is 51 mm long and 16 mm
    across on 1/4 in barbs, which is about what a commercial inline valve is.
    The first estimate paired a 6.35 mm ball with a 3 mm seat, which was wrong in
    a way worth recording. Cracking pressure is net ball weight over SEAT area,
    so a larger seat lowers it, and a la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
2026-11-10 Specify the loop instrumentation, and read the PI it would produce
    Adds instrumentation.py. Two questions with less obvious answers than they
    look.
    PRESSURE. The whole signal lives under one psi: the 622 mm tank is 0.92 psi
    and the derived pulse is 52 mmHg. An ordinary 0-30 psi dial gauge resolves
    16 mmHg per percent of scale, so a third of the signal is the width of the
    needle. Range beats accuracy class here. Two instruments, not one: a clear
    standpipe for the mean, reading directly in the millimetres the head budget
    is written in, and a MEMS transducer for the waveform.
    The standpipe has to be throttled. A free liquid column is an oscillator at
    sqrt(2g/L)/2pi, which at 622 mm is 0.89 Hz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
2026-11-10 Give the pressure table its millimetres-of-fluid column
    That is the unit the head budget is written in and the unit a standpipe
    reads in without being asked, so leaving it out made the one instrument
    that needs no conversion look like the one that needs the most.
2026-11-10 Draw the loop: header tank to head, with bores, lengths and fittings
    A dimensioned schematic of the whole circuit. Vertical is to scale in
    millimetres because elevation is what drives the loop and the standpipe
    heights mean nothing without it. Horizontal is arrangement only. Line width
    is proportional to bore, so the step down into the phantom is visible rather
    than merely stated.
    Nine runs ballooned A to I on the drawing and specified in the table under
    it: where each one goes, its bore, its length, the head it eats and what it
    has to be made of. A second table covers the fittings and instruments.
    Every length and bore is read out of head_budget.SEGMENTS by name, and the
    names are checked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
2026-11-10 Price the gap between the architecture the teams were sent and the one on the bench
    GROUP-2_pulsatile-flow-loop.md tells both teams: "Positive-displacement
    piston as the ventricle, into a compliance chamber, into an adjustable
    resistance, returning to a reservoir. Check valves on either side of the
    piston close the loop." That is Greaby's topology, call it B, and in it the
    piston IS the pump: it supplies the mean flow and the pulse together, there
    is no elevated tank, and there are two check valves.
    The bench is being built as A: a header tank supplies the mean flow, the
    piston tees in and adds only the pulse, one check valve keeps that pulse out
    of the feed. syringe_drive.py has said so in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
2026-11-10 Adopt the sent topology: constant-head jar, R1, plenum upstream, no check valve
    The diagram that actually went to the teams has a constant-head jar at 1.2 m
    with an overflow standpipe pinning the level, R1 as a measured length of
    narrow tubing rather than a check valve, the plenum UPSTREAM of the phantom,
    pressure taps at P1 and P2, and "no tees in the straight run or the block".
    These files had three of those wrong and the diagram was right every time:
    the plenum has to be upstream, because its job is to round the pulse
    before the Doppler sees it, and downstream of the lumen it would be
    shaping what happens after the measurement;
    R1 replaces the check valve;
    the taps cannot s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
2026-11-10 Name a verified P1/P2 sensor, and flag that the ball check cannot go in this loop as drawn
    The sensor is Honeywell ABP2DANT005PG2A3XX, checked against Honeywell's own
    datasheet rather than a distributor listing, because the last part number in
    these notes was a wildcard that found nothing.
    What the datasheet settles. The fourth field of the part number is the media
    option: N is "dry gases only", T is "liquid media, food-grade silicone gel".
    Two parts that differ by one letter, one of which the blood-mimicking fluid
    would destroy. AN is the barbed port and VN the barbless. Update rate is
    about 200 Hz against the 110 Hz this file asks for, supply is 3.3 V, and the
    digital listings are I2C at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
2026-11-11 Judge the single-inlet modules already on the shelf on the right axis
    A single inlet means GAUGE, referenced to the air around it, which is the
    right reference for this loop. The usual range is right too: the common
    MPS20N0040D module is 0-40 kPa and the peak here is 9.3 kPa, 23 percent of
    scale, the same place on the dial as the Honeywell part. So those modules
    were not the wrong idea and this file should not have jumped straight to a
    catalog part without asking what was already in the drawer.
    The bottleneck is the ADC bolted to the sensor, not the sensor, and the
    honest unit is not samples per second. It is samples across the 100 ms
    systolic upstroke, because that is the feature the phant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
2026-11-11 Explain what "mm of head" means, because the tables did not
    Every pressure in this project is written as a height of fluid and nothing
    ever said why, which makes one line read as nonsense: R1 is 182 mm of tubing
    and "costs 780 mm of head". A 182 mm thing cannot use up 780 mm of anything,
    so stopping on it is the correct reaction.
    The two columns are both in millimetres and they are different quantities.
    Length is a length. Head is a PRESSURE, written as the height of a fluid
    column that would produce it, and it says nothing about how long the part is.
    A garden hose nozzle is 20 mm long and drops most of the pressure in the
    hose, for the same reason: resistance goes as 1/bore^4.
    Why write p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
2026-11-11 Add a one-page version of the loop, in units people already own
    loop-diagram.png is the working drawing: nine runs ballooned, every length
    and bore and pressure drop in a table under it. It is correct and it is a lot
    to hand someone.
    This is the same loop said simply, and the simplification is mostly one
    decision: stop writing pressure as millimetres of head. That unit is right
    for the budget arithmetic and wrong for a reader, because the drawing then
    carries two columns of millimetres that are different quantities. Here
    pressures are mmHg, lengths are only ever lengths, and shares of the budget
    are percentages with no unit at all.
    So the jar is "1.2 m, which is the whole push, 92 mmHg". R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
2026-11-11 Put the inch-to-mm conversions on the one pager, because it read as 1/4 = 3 mm
    The page had "1/4 inch tubing for everything but two places" a few lines
    above "3 mm tubing for the last 150 mm", with no conversion anywhere. Three
    bores, two of them named in inches, is exactly the setup for reading those
    two as the same size. They are not: 1/4 inch is 6.35 mm, which is more than
    twice 3 mm, and the 3 mm one is 1/8 inch at 3.18 mm.
    So the buy list now opens with the three bores and what each is for, with
    the millimetres against every imperial size, and says outright that 1/4 inch
    is not 3 mm.
    It also explains how barbs are named, which is the other half of the same
    confusion: a barb is named f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
2026-11-11 Put the bore on every run of the one pager, not just in the buy list
    The buy list said "1/4 inch for everything but two places", which leaves the
    reader to find the two places, and finding them is the part that goes wrong.
    Every run now carries its own size label sitting on the pipe: eleven of them,
    covering the drop from the jar, R1, both sides of the piston junction, the
    plenum riser, the run to the reducer, the settling run, the lumen, and the
    two runs back to the reservoir.
    Each label gives both spellings, 1/4 in over 6.35 mm, so there is no point on
    the drawing where someone has to convert in their head. R1's says 2 mm bore.
    The lumen's label says "3 mm cast lumen" rather than repeati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
2026-11-11 Size the plenum, say what it is made of, and answer where the loop may rise
    WHAT IT IS MADE OF. Rigid, clear, upright, and the first of those is the one
    that matters: the plenum's job is to be the only soft thing in the loop, so a
    soft-walled vessel adds its own compliance in parallel with the air and the
    knob stops being a knob. Quantified as each candidate's wall compliance
    against the 20 mL of air inside it: a 60 mL syringe is 0.43 percent, a
    serologic pipette 0.03, a glass tube 0.005, and a soft silicone bulb is 265
    percent, which is what failing looks like.
    Recommendation is a 60 mL syringe, tip down, plunger in and blocked. It is
    graduated, so the air volume is both the setting and th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
2026-11-11 Say "clamped", not "blocked": one word away from meaning the opposite
    The plenum note said the syringe plunger was "blocked so it cannot creep". In
    a flow loop, next to a part everyone calls "the block", that reads as the
    syringe being plugged. It is the opposite: the tip stands OPEN to the loop
    and the plenum does nothing at all if it is not, because fluid has to get in
    and out of the barrel for the air above it to do any work.
    So the wording is now "the plunger stays in and gets CLAMPED so it cannot
    slide", everywhere it appeared, and plenum.py carries a short paragraph
    saying outright that nothing is plugged and what each part of the assembly is
    doing: fluid rises into the barrel from th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
2026-11-11 Say which thing is the compressible one, because the plenum makes no sense otherwise
    "How does fluid go in if there is air in there, isn't the air incompressible"
    is the right question and it is exactly backwards, which means the files
    never said the one thing the whole mechanism rests on: the AIR is the soft
    one. The liquid is the rigid one.
    As numbers, pressure needed to squeeze one percent of the volume out:
    air at 1 atm 0.21 psi
    150 mm of 1/4 in silicone 0.55 psi
    150 mm of 1/4 in braided PVC 5.14 psi
    the blood-mimicking fluid 3191 psi
    Air gives way about sixteen thousand times more easily than the fluid. So
    when the piston pushes, nothing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
2026-11-11 Plenum syringe is in hand; record it and what is still unmeasured about it
    Bought 2026-11-10, so the BOM line moves to HAVE and plenum.py gains a
    PLENUM_SYR entry in the same shape as the motor and nut tables: bore, plunger
    cross and usable stroke all None until somebody puts calipers on them, so
    they cannot be quoted back later as though they were measured.
    What each of the three actually changes, which is worth knowing before anyone
    bothers:
    barrel bore how far the level moves per mL, so whether the breathing is
    visible, and the force on the plunger, so whether it creeps
    plunger cross the only number the printed lock needs
    usable stroke whether 50 mL of ai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
2026-11-11 The pressure sensor was already chosen: MPX5050GP, in the phase-0 doc
    capstone/GROUP-2_phase0-bench-rig.md specifies MPX5050GP with the reasoning
    attached, and reaches two conclusions this session reached again from
    scratch. Buy TWO, one each side of the compliance chamber, which is P1 and P2
    under other names. And on the cheap modules: "at 40 SPS a 1.2 Hz beat gets
    about four samples on the systolic upstroke, the dicrotic notch smears away
    entirely, and anything above 20 Hz aliases. Resolution is not the
    specification that matters here. Bandwidth is."
    Four samples on the upstroke is the same number I derived two days of
    conversation later without looking. That is the cost of not reading th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
2026-11-11 Push-fit RO fittings: yes, and buy the 3/8 inch ones
    They are a better fit for this rig than barbs, for reasons that have nothing
    to do with price. The bodies are rigid acetal so they add no compliance at
    all, unlike a barb on soft tube. The tubing that goes with them is LLDPE,
    which is the stiffest thing on the list: 150 mm of it steals 0.08 percent of
    the stroke against braided PVC's 0.40 and silicone's 13.5. Five times better
    than what this file has been recommending. And they come apart and go back
    together by hand, which matters because the deliverable is a sweep: taking
    the loop apart and rebuilding it the same way, repeatedly.
    THE TRAP IS THE SAME ONE AS BEFORE, wearing different clo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
2026-11-11 That RO kit covers the whole loop, and its 1/4 in reel is a better R1 than 2 mm
    The kit has both reels, and they do two different jobs. 30 ft of 3/8 in OD is
    a 6.35 mm BORE and is the trunk, exactly as drawn. 30 ft of 1/4 in OD is a
    4 mm bore and must NOT be the trunk: at 4 mm the plumbing eats more than the
    jar provides and R2 comes out negative.
    But that 4 mm reel turns out to be a better R1 than the 2.0 mm tubing this
    file specified before the kit existed, so R1_BORE moves to 4.0.
    trim resolution 2.9 m of it instead of 182 mm, which is 29 mm of length
    per 1 % of head instead of 1.8. Sixteen times easier to
    cut to a number against the manometer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
2026-11-11 Size R2 in Cv, which shows the obvious parts are all the wrong size
    R2 has to sit near 169 mm of head at 250 mL/min and sweep either side. In
    valve terms that is a Cv of roughly 0.09 to 0.25. Reading the same arithmetic
    backwards is what decides the part:
    fine metering valve Cv 0.03 3407 mm WIDE OPEN, more than the jar has
    small needle valve Cv 0.10 307 mm, no room left to open
    ordinary needle valve Cv 0.30 34 mm, closes into range. Right size
    1/4 in ball valve Cv 1.00 3 mm
    3/8 in ball valve Cv 4.00 0 mm
    That turns "not a ball valve" from an opinion into a number: wide open it
    gives 3 mm, so every setting anyone cares about lives in the f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
2026-11-11 Put the manometer back on the drawings, and work out that it reads the split
    Asking what the manometer is turned up a real gap: neither drawing showed
    one, while head_budget.py said four times to trim R1 and R2 "against the
    manometer". A tube nobody has drawn is a tube nobody will build. It had
    fallen off during the topology rewrite, when the no-tees-in-the-straight-run
    rule removed it from where it used to sit, and it never went back anywhere
    legal. It tees into the TRUNK at the piston junction, which breaks no rule.
    It is a clear tube, open at the top, with loop fluid standing in it. Its
    height IS the pressure. That is the whole instrument.
    And working out where it should stand turned up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
2026-11-11 Every pressure in the loop, in all four units, derived from one place
    They were scattered across head_budget, instrumentation, plenum, feed_tubing
    and ball_check, each in whichever unit suited its own argument: millimetres
    of fluid for the budget arithmetic, kPa for sensor ranges, psi for ratings,
    mmHg for the physiology. All correct and no two comparable at a glance.
    Writing them side by side immediately caught a disagreement. The pulse came
    out 340 mm here against instrumentation.py's 508, because this file took the
    mean over the upstroke where the other differentiates the real BEAT array for
    the true peak. A 1.49x gap between two files describing the same beat, and
    exactly what a consoli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
2026-11-11 Fix a percentage printing as '0 times the entire pulse'
    %.0f on a ratio of 0.41. It is 40 percent of the pulse, which is the
    point of the sentence.
2026-11-11 What the manometer is made of: clear vinyl, a metre stick, a blunt needle
    Clear, because the meniscus is the reading, which rules out the RO kit's own
    tube: it is white LLDPE and you cannot see a level through it. Clear vinyl
    from a hardware store is the easy answer.
    And soft is fine HERE, which is worth saying out loud because every other run
    in this loop forbids it. The manometer carries no flow and sits behind a
    restriction, so its compliance never reaches the pulse and there is nothing
    for a soft wall to steal. It only has to be straight and vertical, which tape
    and a metre stick do.
    TALL ENOUGH NOT TO OVERFLOW, and the number is not the working pressure. If
    R2 is ever closed the flow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
2026-11-11 The manometer is three parts at once, not three options
    "What is the manometer made of" got answered with two tables, one of bores
    and one of needle gauges, and they read as menus to pick from. They were the
    working behind a decision already made. That is a presentation failure, not a
    reader failure: a table of four numbers next to a question looks like a
    choice no matter what the surrounding prose says.
    So the section now opens with the parts list and says outright that it is not
    a choice:
    1. a clear vinyl tube, 6.35 mm bore, 1.3 m long
    2. a metre stick, with the tube taped along it
    3. a 16 gauge blunt luer needle, between the tube and the loop
    The needle tees into the trunk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
2026-11-11 ABS on the printer: gate every fitted part until the coupon is measured again
    HOLE_SHRINK is the number every press and slip fit in this model rests on,
    and it is a property of the FILAMENT, not the printer. The 0.24 mm was
    measured in PLA on fit coupon rev 2.
    ABS changes it twice over. PLA's figure was almost all fixed extrusion
    encroachment, about 0.12 mm per wall, which is why a single constant worked.
    ABS shrinks roughly 0.7 percent on cooling against PLA's 0.3, which adds a
    term that scales with the hole:
    LM8UU bore, SLIDING 15 mm 0.06 mm extra
    608 pocket, press 22 mm 0.09 mm extra
    rod bore, press 8 mm 0.03 mm extra
    collar bore on the barre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
2026-11-11 Wider and shorter: price it, and find that the two halves do different jobs
    ABS on the printer and a 184 mm unbroken length is where ABS lifts corners,
    so: what is the length made of, what can come out, and is the shape even the
    thing worth changing.
    Where the 184 goes. The saddle is 30 percent and the travel 24, and both are
    soft: the collars do the gripping so the saddle only stops the barrel
    rolling, and the travel is priming headroom against a 4.17 mm beat. The
    coupler stack is another 18 and only a belt takes it out. Everything else is
    structure.
    long wide aspect footprint warp idx
    as built, PLA 184 mm 81 mm 2.27 149 cm2 1.23
    travel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
2026-11-11 Manometer: wider changes nothing, shorter comes from the range. And slice ABS
    WIDER DOES NOTHING TO THE HEIGHT, and that is the nature of the instrument
    rather than a limitation of this one. The column stands at h = p/(rho g) and
    there is no diameter in that expression. A 50 mm tube stands at exactly the
    same 405 mm as a 6 mm one and holds 795 mL instead of 13. Width buys a
    slightly easier meniscus and nothing else.
    SHORTER COMES FROM THE RANGE. The 1.3 m was sized for the fault case, a shut
    R2 with no flow, which is the only thing that sends it to the jar's full
    height. Across the whole sweep only R2 moves, and the tube only ever reads
    275 to 535 mm.
    So: 700 mm, with its top returned to t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
2026-11-11 The frame is not reprinted, so pin its geometry and guard it
    Decided 2026-11-11. The PLA frame on the bench stays, which means its
    geometry stopped being a design choice and every part that mates with it now
    has to accept what was actually made.
    Two constants already carried an "as built" comment, and a comment does not
    stop anything. ROD_SPACING is the one that mattered most and had no marking
    at all: the carriage's two LM8UU bores sit on it, so changing it while
    designing the carriage would produce a part that verifies perfectly against
    the model and does not go on the rods. That is the saddle-bore failure again
    with a different constant.
    So FRAME_AS_BUILT records all 27 of them and chec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
2026-11-11 No, the manometer does not replace P1 and P2, and P1's case is not the old one
    Three instruments, three different measurements, and only one pair overlaps.
    manometer the MEAN at the tee. It sets R1, because 1 - reading/jar IS
    the forward fraction and nothing else on the bench reads that
    P2 the WAVEFORM at the block's inlet. The deliverable
    P1 the WAVEFORM before the plenum
    The manometer cannot stand in for either, because it is deliberately
    throttled to 0.05 Hz so it CANNOT follow the pulse. That is what makes it a
    clean mean rather than a shortcoming.
    And P1's case is better than the one in the phase-0 document. That document
    wanted two sensors so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
2026-11-11 P2 with R2 shut, and it reverses the check valve recommendation
    Shutting R2 stops the flow, and with no flow there are no losses anywhere, so
    everything upstream of it sits at the jar's 1200 mm: 91.5 mmHg, 1.77 psi.
    That part is harmless. The question is where the piston's half millilitre a
    beat goes once the forward path is closed.
    escape path for the piston peak mm peak psi
    R1 open, plenum 20 mL 1564 2.31
    R1 open, plenum EMPTY 2177 3.21
    check valve fitted, plenum 20 mL 1779 2.62
    check valve fitted, plenum EMPTY 14099 20.80
    The last row is the whole thing. With a check valve, an empty plenum and R2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
2026-11-11 One pager: a pressure profile strip, every station in mmHg and psi
    Adds a strip under the schematic plotting head against position, with every
    station labelled in all three units at once. It goes on its own band rather
    than on the pipe, because each run already carries a bore badge and a second
    badge on the same line would make the drawing unreadable.
    the jar 1200 mm 92 mmHg 1.77 psi
    after R1 412 mm 31 mmHg 0.61 psi
    P1 405 mm 31 mmHg 0.60 psi
    P2 396 mm 30 mmHg 0.58 psi
    into the block 266 mm 20 mmHg 0.39 psi
    out of it 198 mm 15 mmHg 0.29 psi
    after R2 21 mm 2 mmHg 0.03 psi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
2026-11-11 Cutting the rods, and the fact that nothing holds them
    Two questions, and the second is the better one.
    CUTTING. Not with a hacksaw. Hardened linear shaft is case hardened to about
    60 HRC and an HSS blade is 64, so the blade is barely harder than the work
    and gives up in a few strokes. The failure mode is not "this is slow", it is
    buying the shaft, reaching for the saw already on the bench, and concluding
    the wrong rod was sent. Abrasive chop saw, angle grinder with a thin cutoff
    wheel, or a rotary tool. Two rods at 122 mm, so one 300 mm length does both
    with 56 mm over.
    And chamfer both ends, which is the step that gets skipped. An LM8UU is a
    cage of ball tracks under a thin sleeve, and a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
2026-11-11 One plate for the four small parts, and the carriage held back
    Four parts at 6, 6, 9 and 14 minutes printed separately is four ABS bed heat
    cycles for 35 minutes of extrusion. On one plate it is 26m27s and one heat
    cycle. 112 x 45 mm on a 220 mm bed, 7 g.
    make_plate.py takes its orientations from print_plate.ORIENT rather than
    choosing its own, because that table is where the reasoning lives: the collar
    lies with its bore vertical so the split needs no support, the saddle cap
    goes face down, and so on. Two files picking orientations independently is
    how a part gets printed upside down.
    THE CARRIAGE IS NOT ON IT, and the reason is one the grep for HOLE_SHRINK
    misses. The carriage never name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
2026-11-11 ABS hole shrink measured, and the predicted thermal term is simply not there
    From the coupon, 2026-11-11: an 8.24 drawn bore came out 8.00 and a 22.20
    drawn pocket came out 22.00 with a 608 seating well in it. So 0.24 and 0.20.
    The proportional term I predicted did not appear. ABS shrinks about 0.7
    percent on cooling against PLA's 0.3, so a hole term that scaled with
    diameter was the expectation and the data has none of it. The most likely
    reason is the enclosure: the part stays near its glass transition while it
    prints, shrinks while still gripped by the bed, and arrives at
    drawn-minus-extrusion the way PLA does.
    The 0.04 between the two numbers is less than calipers on a printed hole
    wil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
2026-11-11 Wiring P1 and P2, and the divider that stops them killing the Pico
    Kevin has the sensors. This is how they connect.
    THE ONE THING THAT BREAKS A PICO. The MPX5050GP wants 4.75 to 5.25 V and
    swings its output to 4.70 V at full scale. The Pico's ADC pin is 3.3 V. Wired
    straight to GP26 that is 4.7 V into a 3.3 V pin.
    Running the sensor at 3.3 V instead is the obvious dodge and it is wrong:
    the datasheet specifies 4.75 V minimum and calls the part ratiometric only
    "within this specified excitation range". Below that you are off the
    characterised curve with no way to know by how much. Supply it properly at
    VBUS and divide the output.
    10k over 20k puts full scale at 3.13 V, loads the sensor at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
2026-11-11 Carriage printing, with the one unrecoverable dimension taken out of it
    Printing the carriage meant cutting the nut interface, and the nut on the
    bench is the uxcell POM one whose dimensions were still all None. The pattern
    in the model was the brass one: four M3 on a 16 mm bolt circle.
    Looked for the uxcell figures rather than guessing and did not find them, but
    the search surfaced the thing that matters: POM T8 nuts are sold with 18 mm
    hole spacing against the brass standard's 16. At 16 against 18 the M3 centres
    land 1 mm apart radially, so the two sets of holes merge into slots and the
    mounting face is scrap. There is no filing your way back from that, and it
    would have been found 82 min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
2026-11-11 rod_lock: Kevin's lockable collar, and a correction that makes it necessary
    I TOLD KEVIN YESTERDAY THAT THE MOTOR BLOCKED ONE DIRECTION. It does not.
    The rods sit at y = +/- 28 and a NEMA17 is 42.3 square, so each rod passes
    6.85 mm OUTSIDE the motor body and sails straight past it. Both ends were
    open the whole time. That turns the retention question from tidy to
    necessary, and the harness now carries a check that says so by name, in
    place of the one that asserted the opposite and passed.
    AND A PLAIN COLLAR CANNOT DO IT. A collar clamped to a rod stops ONE
    direction: it jams against a fixed face when the rod moves toward that face
    and lifts straight off when the rod moves the other way. Bo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
2026-11-11 rod_lock was not in build(), and nothing was watching that gap
    The part existed, printed, rendered and passed its own clearance checks
    while being absent from the registry, so print_plate crashed on a KeyError
    and the BOM would have shipped a line nothing could slice.
    A function is not a part until build() says so. Two checks now stand across
    that seam: every part in build() has a print orientation, and every
    orientation names a part that exists. Both directions, because an orphan in
    ORIENT is as wrong as a missing entry and fails later and more confusingly.
    Pair slices at 29m30s, 8 g.
2026-11-11 The rod lock is in the 3D model, and so is the last 12 mm of shaft
    rod_lock() was printable and in the BOM and still absent from the only
    place anyone actually looks. Added as step 7, straight after the shafts
    go in, mirrored to both rails.
    The shafts were drawn stopping at the rib's back face, X=122, which was
    true before the lock existed. They now run 0 to 134, the length the BOM
    buys, because that last 12 mm is what the lock clamps.
    Two more registry checks, the same gap one layer out: every printed part
    has to appear in the assembly, and the drawn shaft length has to match
    the cut length. Being printable is not the same as being in the build.
2026-11-11 The rod lock's two directions are not the same, and the screw length knew it
    Kevin asked whether the lock just travels forward with the rod. Half right,
    and the half that is right is the half I had not taken in compression.
    Backward, toward the motor, drives the lock into the rib's back face. That
    is compression on a printed wall and it cannot fail. Forward, toward the
    syringe, lifts it off that face and hangs it on two M3 in thread pullout.
    That is the real load path and I had not said so anywhere.
    It still wins by 21000x, so nothing needs redesigning. What does need
    changing is the screw: 12 mm of it is spent crossing the lock before the
    thread reaches the rib, so the M3 x 16 on the buy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
2026-11-11 rod_stop: the forward direction in compression, which is the one Kevin meant
    He said it twice and he is right about the direction. The carriage pushing
    the plunger nudges the rods toward the syringe, and that is exactly the
    direction the rib lock takes in thread pullout rather than compression.
    The magnitude is still small. A recirculating ball bush is the part whose
    job is to NOT transmit axial force: the piston's 20 N, which is mostly seal
    stiction and not pressure, goes plunger -> carriage -> nut -> screw -> 608,
    and what reaches the rod is mu times the bush's radial load, 0.11 N. But
    small is a reason not to worry, not a reason to leave a tension joint where
    a compression one costs one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
2026-11-13 P1 and P2 share the Pico that already runs the motor, and a check that says so
    Kevin is out of spare Picos and has Arduinos and Pis on the shelf. No second
    board is needed and no second board is wanted: the drive uses GP2/3/4 and the
    ADC pins GP26/27 are free, so one board carries both.
    That is not just convenience. P1 exists to tell a bad P2 from a bad PISTON,
    because the step counter is open loop and reports what was commanded rather
    than what the fluid did. That comparison only means anything if the pressure
    samples and the step count share a clock, which they do on one board and do
    not across two USB serial streams.
    Two checks, because the pin assignments live in two firmware files and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
2026-11-13 rod_clamp was never in the BOM, and four rows were invisible in the tally
    lab-phantom flagged that the printed parts still read BUY after they came
    off the machine, and that the tee note still pointed at the dropped check
    valve. Both true. Chasing the first one found worse:
    rod_clamp was in build(), in ORIENT, in the 3-D assembly and sitting on the
    bench, and had never appeared in the BOM once. The registry check added
    earlier this session compares build() against the 3-D model. Nothing
    compared it against the list the students order from, which is the registry
    that costs money when it is wrong.
    Then the status check found a fifth status nobody had declared. The roll-up
    iterated a hand wri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
2026-11-13 The notch is in the lead, and the kit has no film cap
    Two corrections from lab-phantom, both verified.
    PIN 1. These files said "the notch in the side of the package". The
    datasheet says "pin 1 is noted by the notch in the lead", and lab-phantom
    confirms it is plainly visible on the lead of Kevin's actual part. The
    distinction is not pedantry on the one part that dies if it is reversed:
    the package has moulding features of its own, and there is an NXP forum
    thread of somebody asking whether the notched pin might be pin 6. Fixed in
    wiring.py and pico/pressure.py, with a check that tests for the
    instructional form so the correction itself is allowed to stand.
    Also took pins 4, 5 and 6 from "N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
2026-11-13 The notch check was measuring my line breaks, not the instruction
    af92943 went out with this check failing, which I should have caught before
    committing. The cause is worth keeping: the check searched the raw source
    for "notch in the lead" and passed, then I rewrapped the paragraph and the
    datasheet quote split across two A() calls, so the literal phrase was no
    longer contiguous and the check failed on a file whose text was correct.
    A check that fails when the line breaks move is measuring the wrong thing.
    It now renders wiring.report(), collapses the whitespace and tests that,
    which is the text the student actually reads. 96 checks, all passing.
